drunkbatya/DrunkDashboard/hardware/production/DrunkDashboard_v2/schematic.pdf

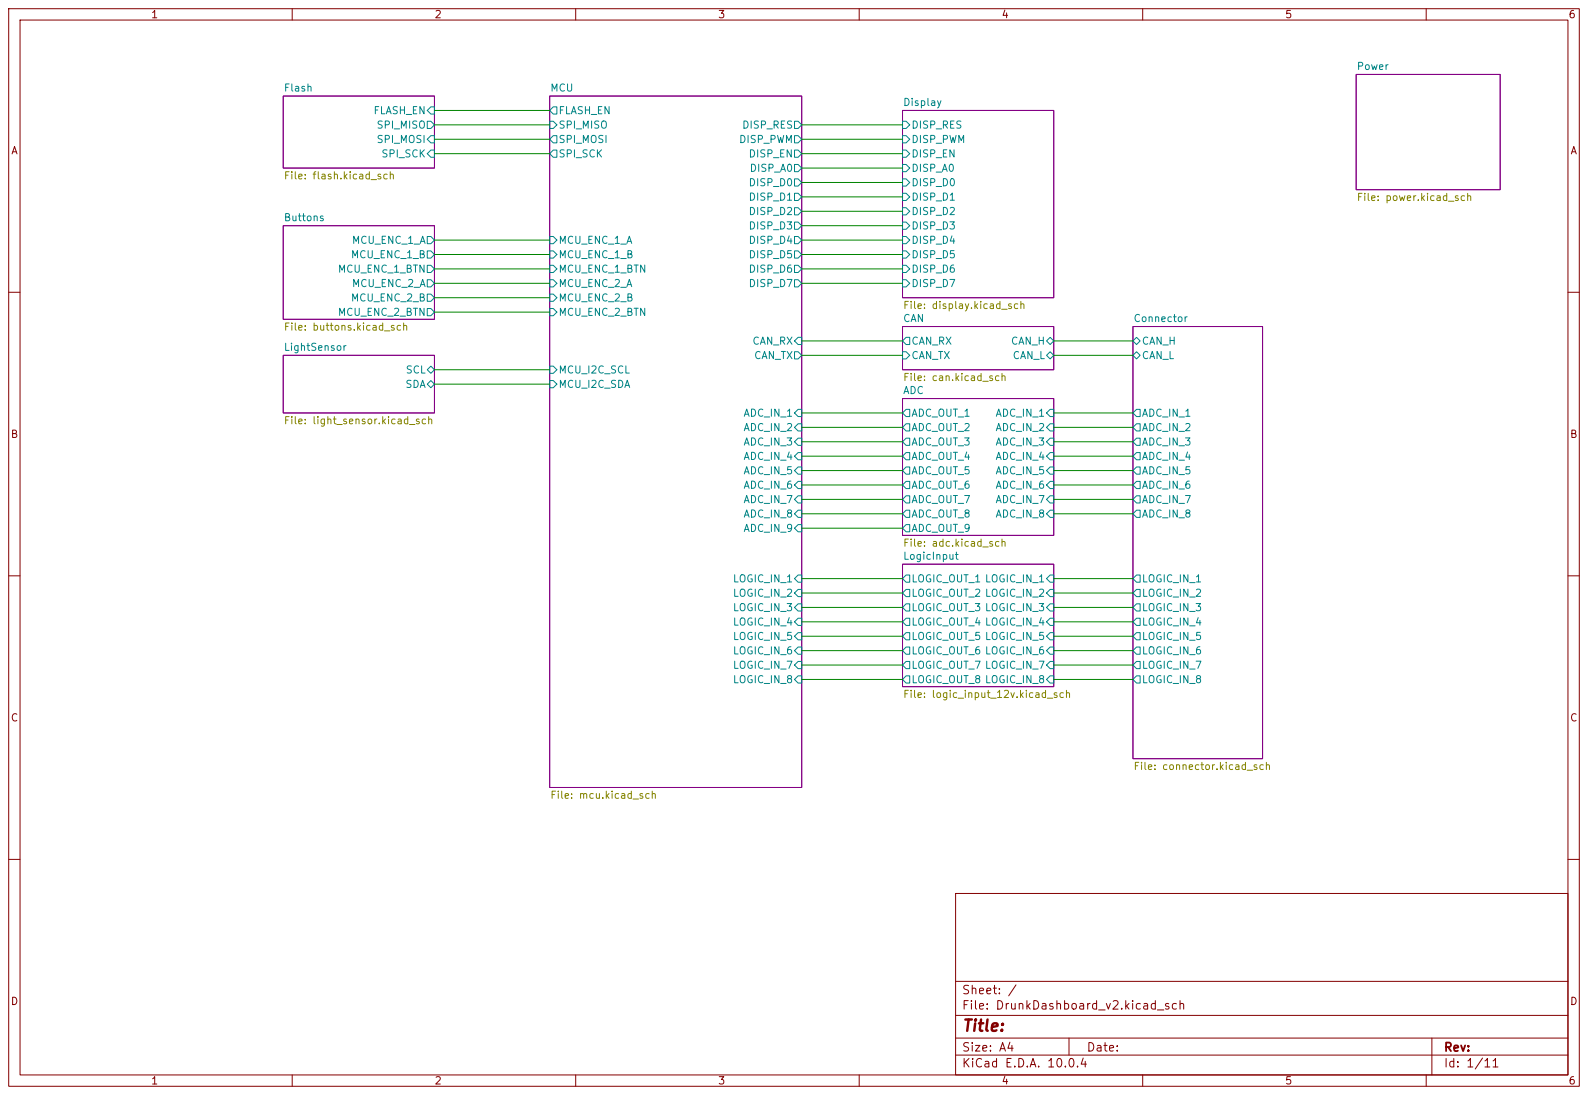
[picture p3: page 1]

LogicInput File: logic_input_12v.kicad_sch SCL SDA

Size: A4 | Rev:
KiCad E.D.A. 10.0.4 | Id: 1/11

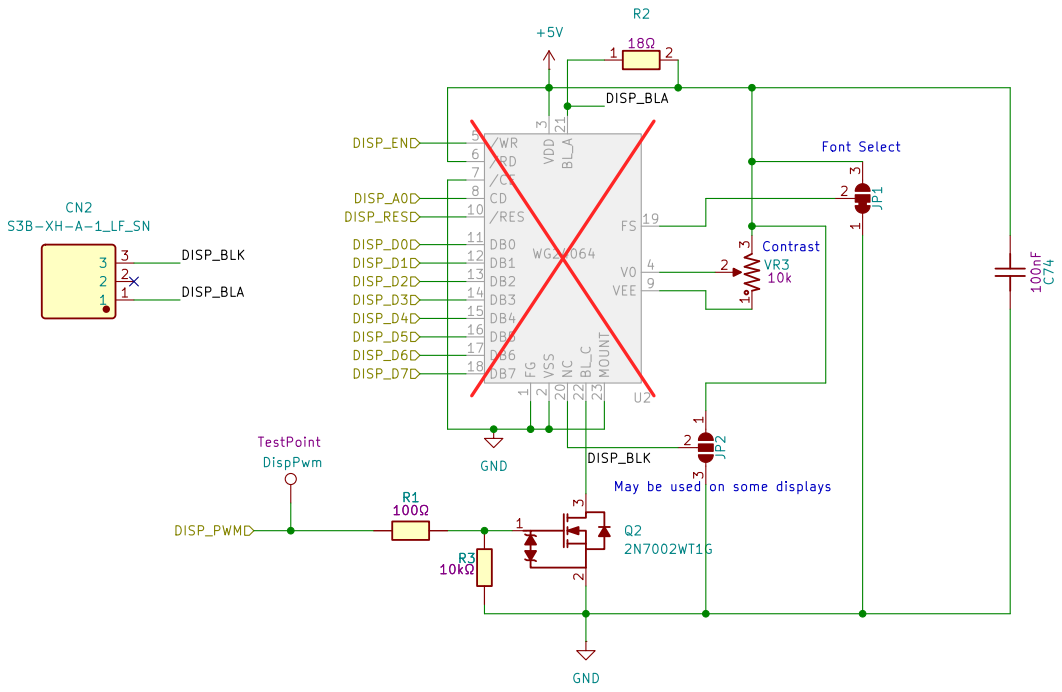
[picture p4: page 2]

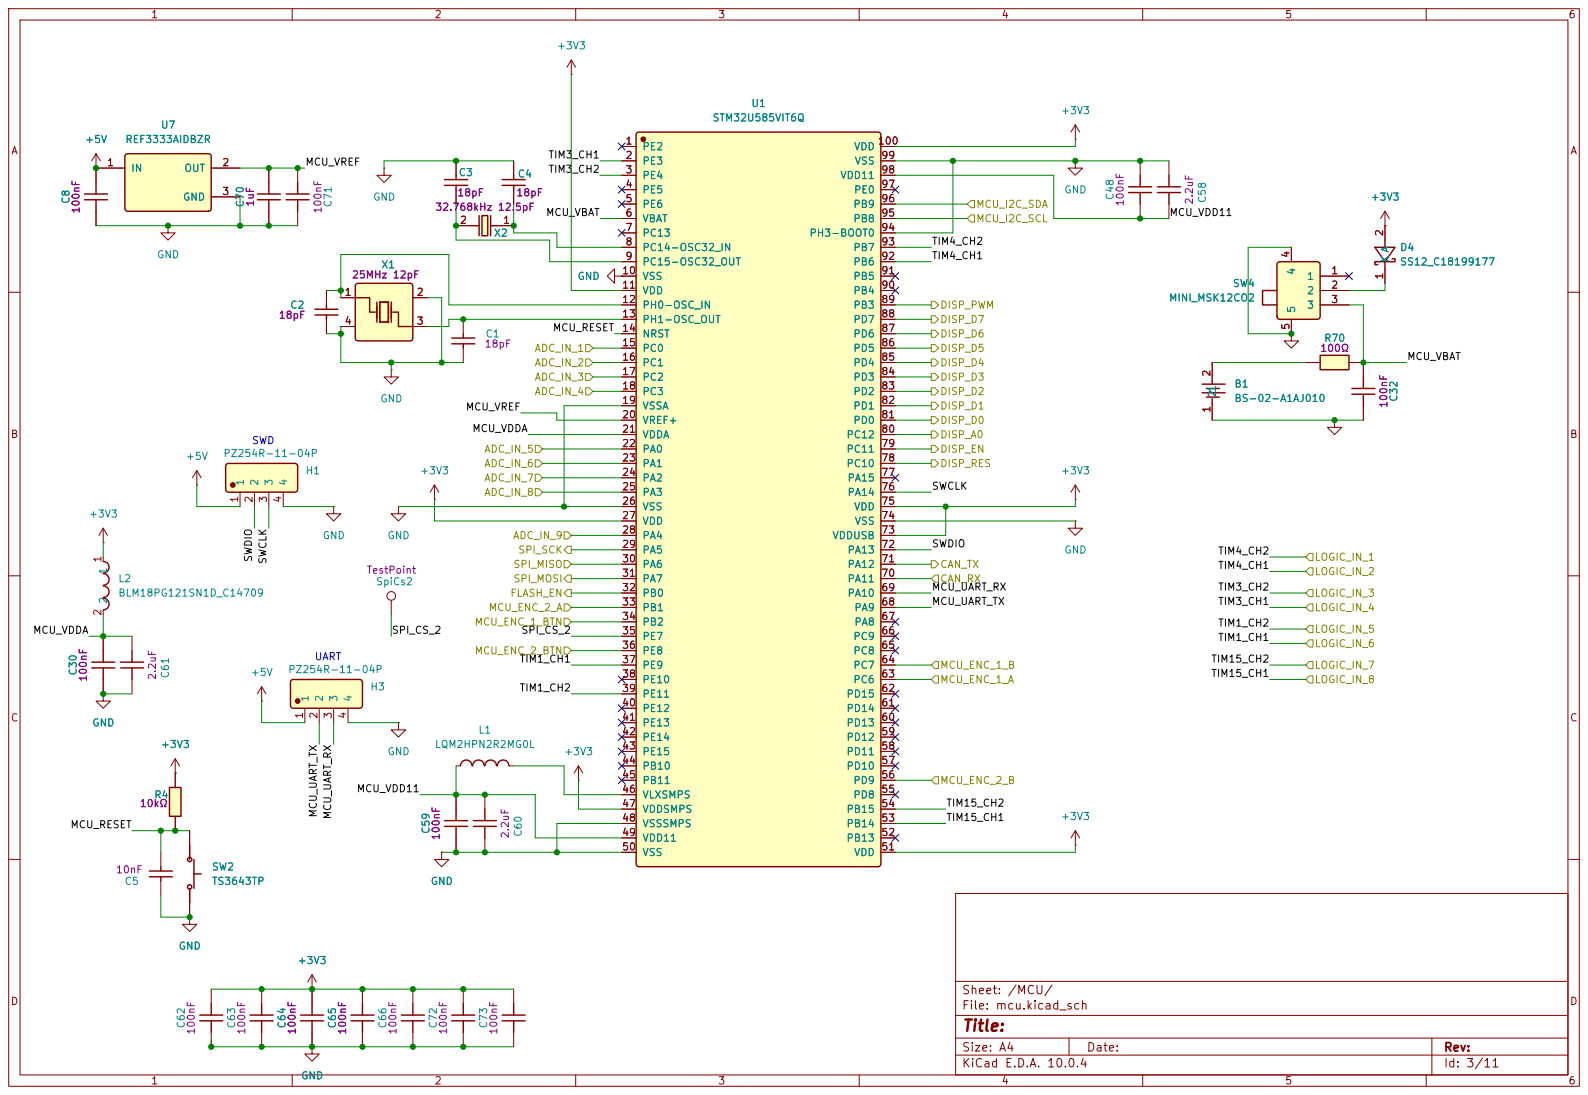
[picture p5: page 3]

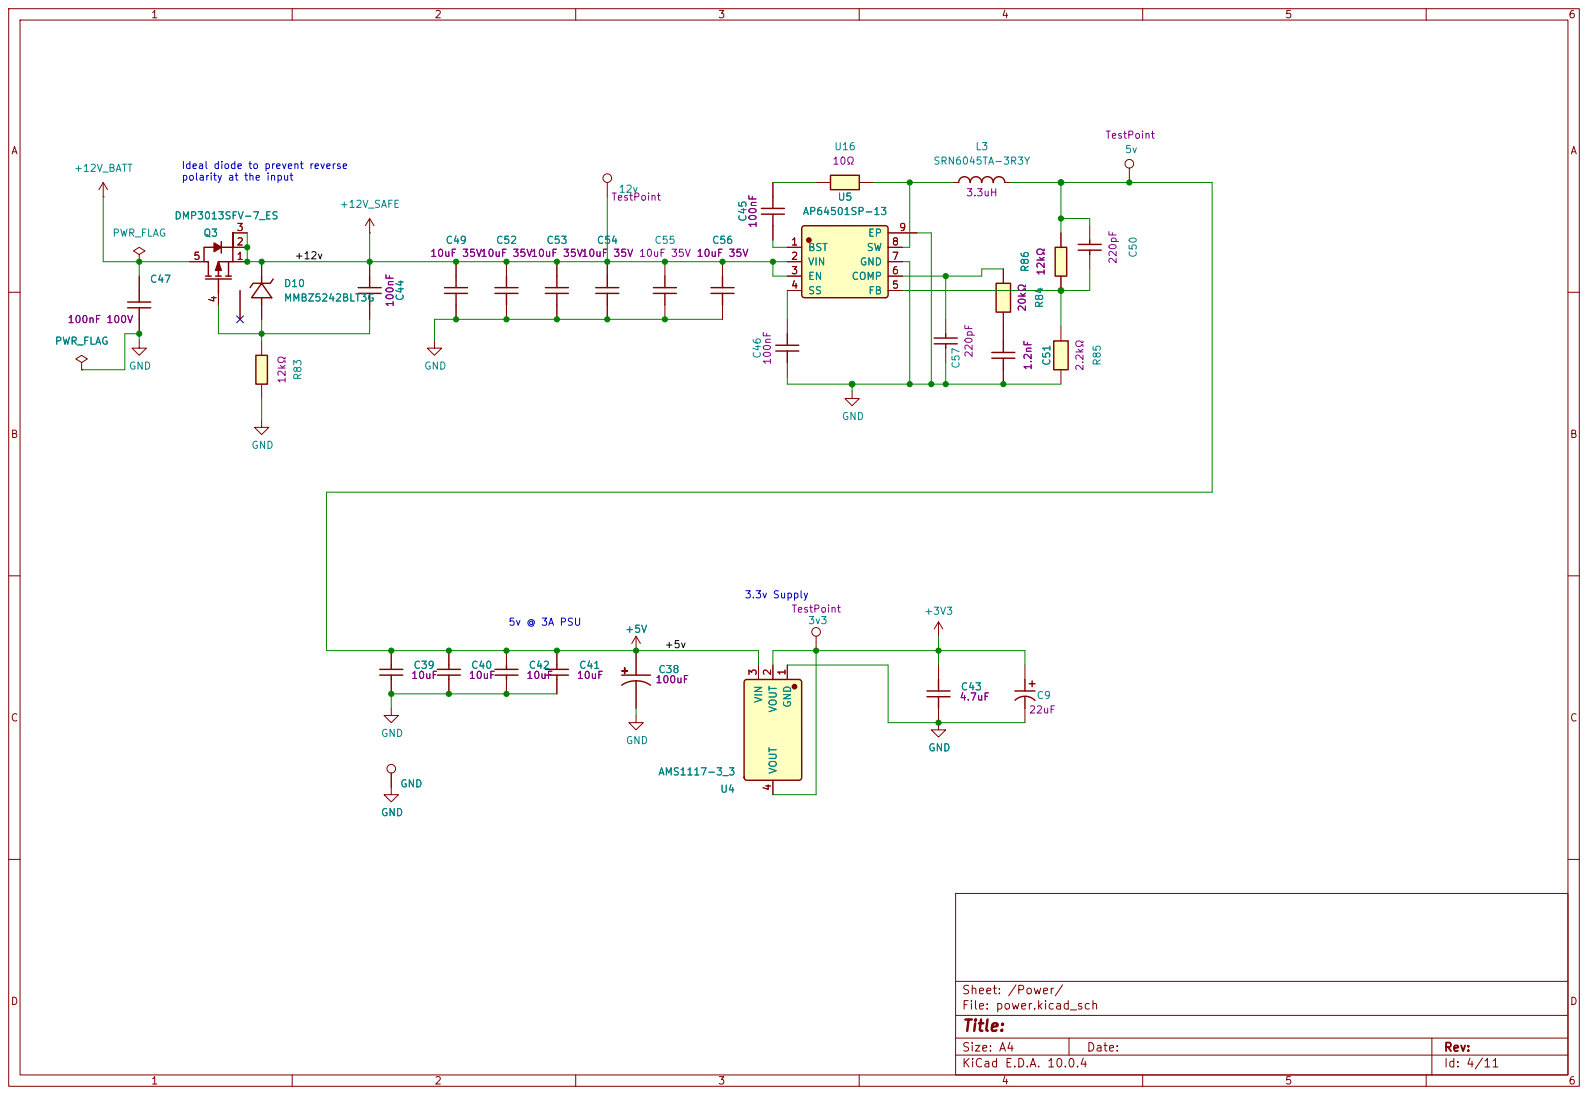
[picture p6: page 4]

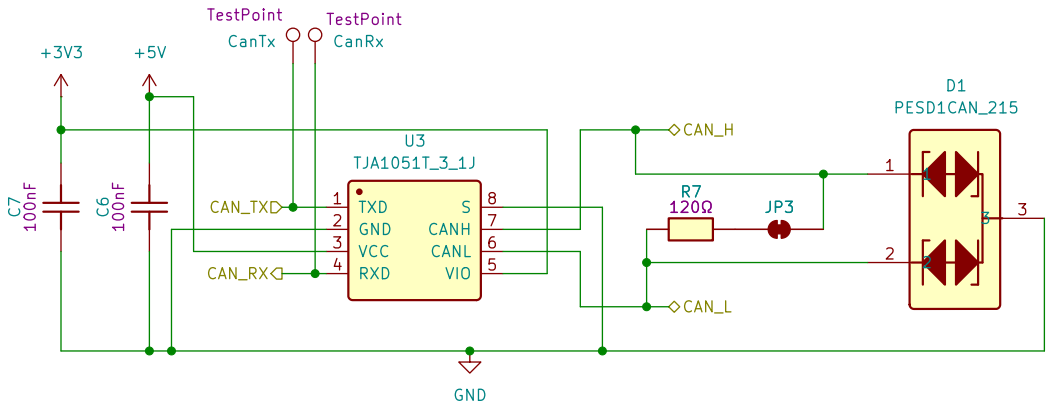
[picture p7: page 5]

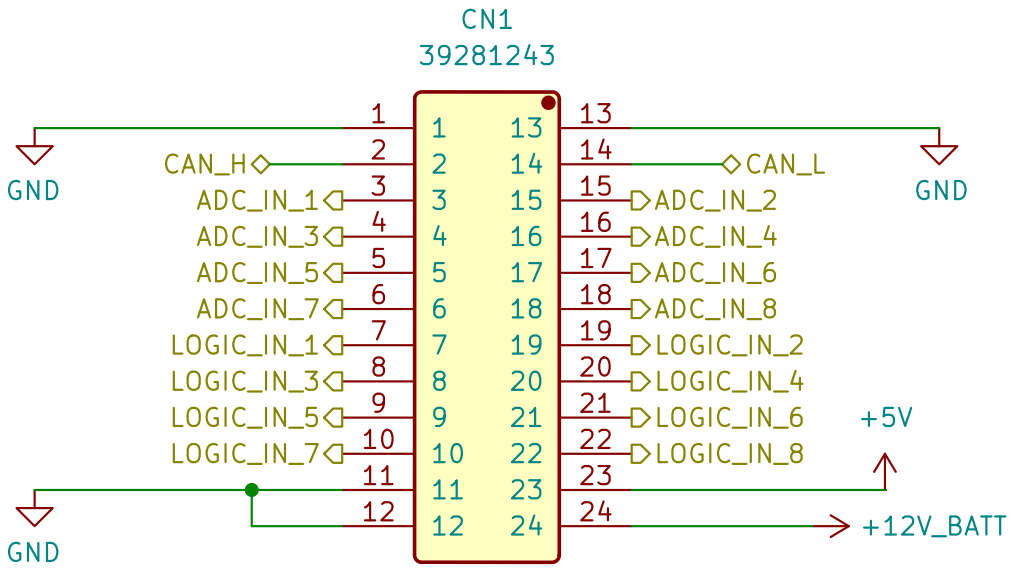
[picture p8: page 6]

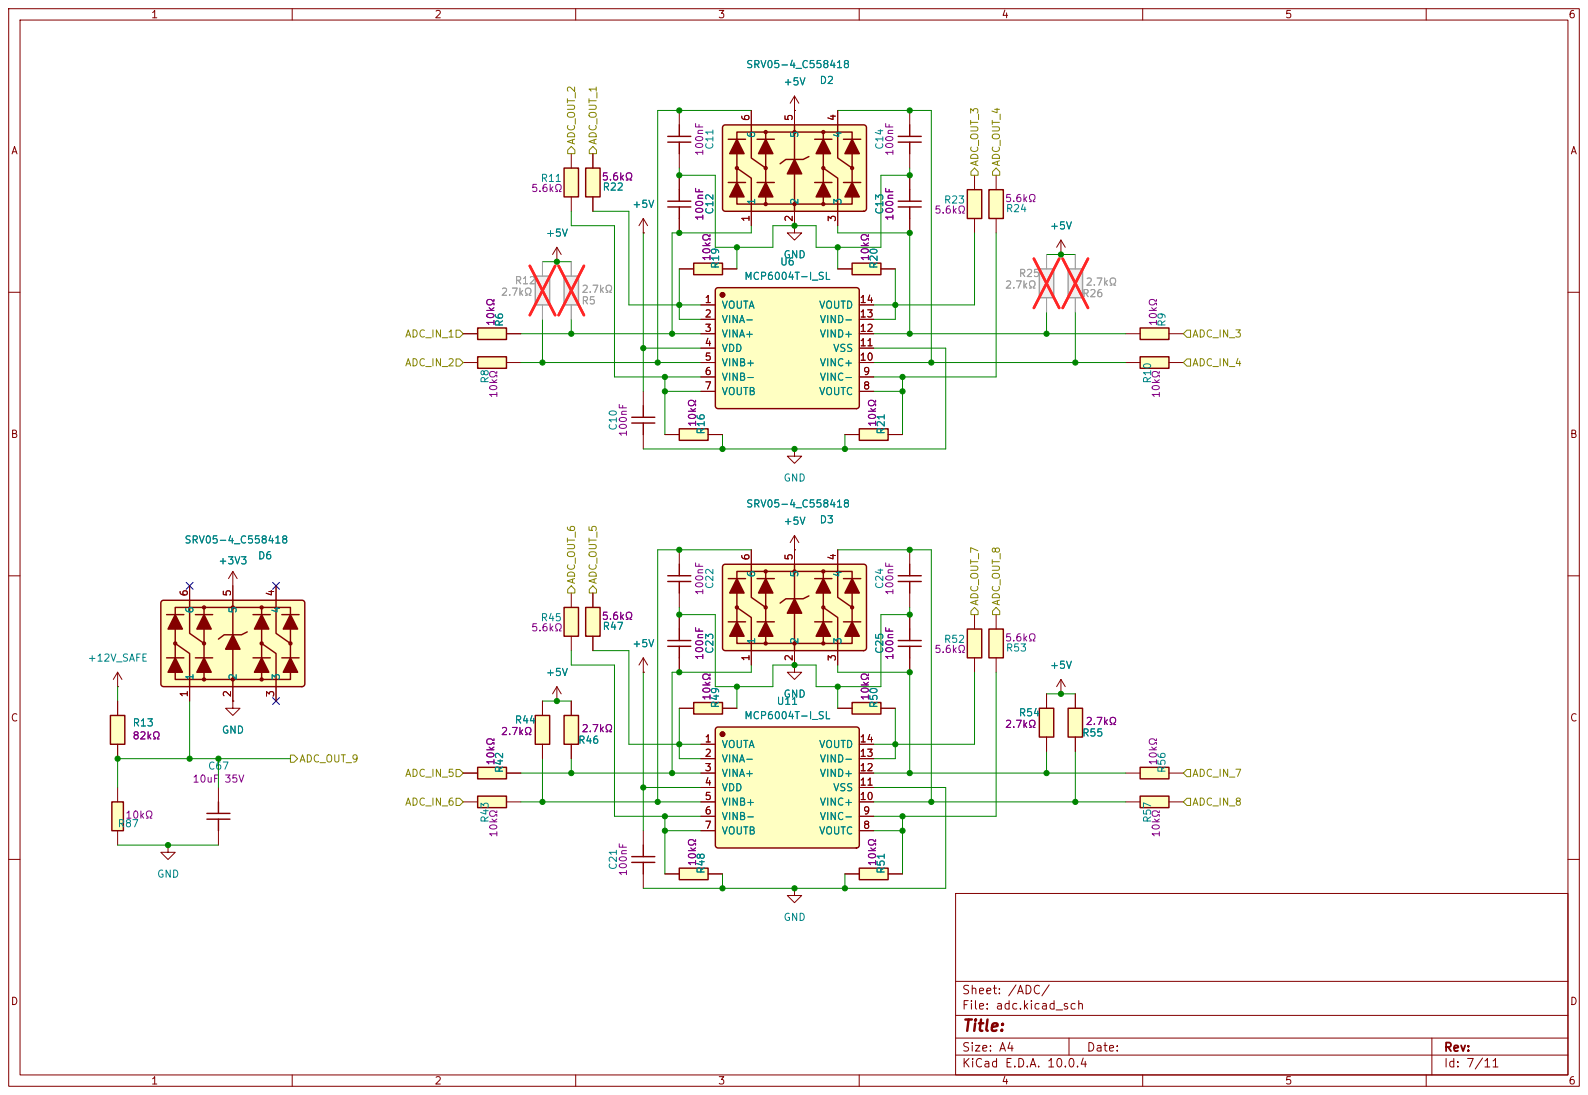
[picture p9: page 7]

VINC+ 10 VSS 11 VIND+ 12 VIND- 13 VOUTD 14 GND

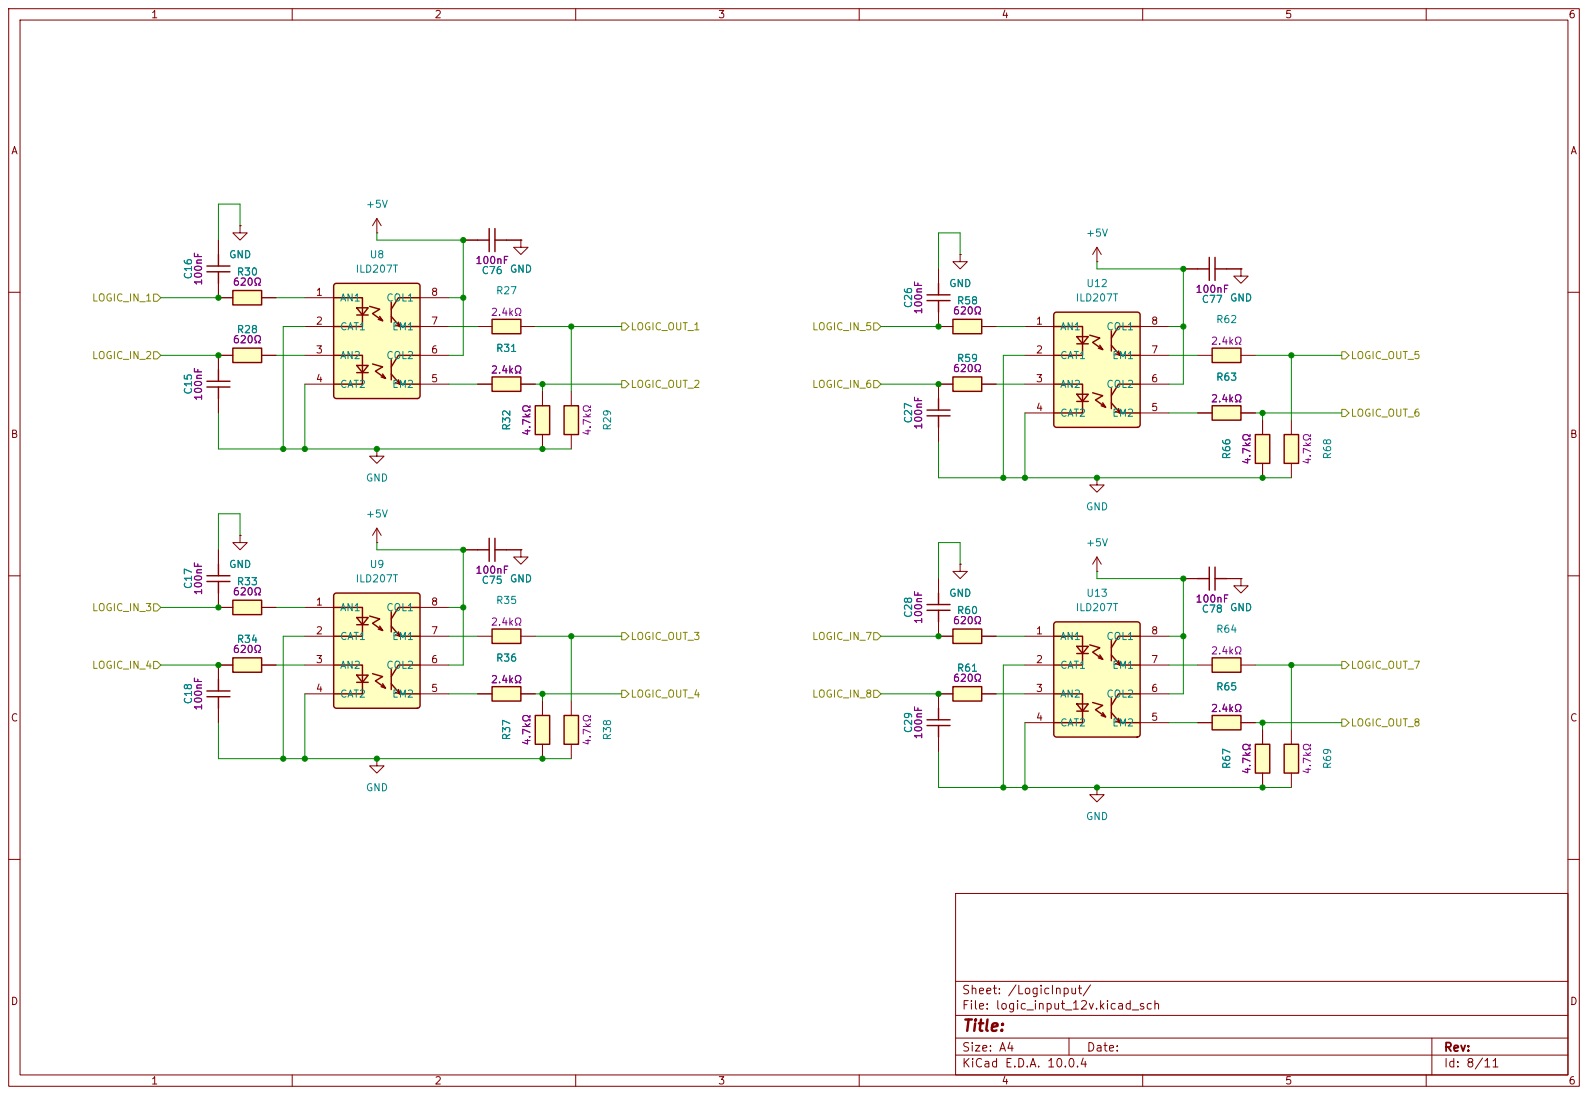
[picture p10: page 8]

AN2 3 CAT2 4

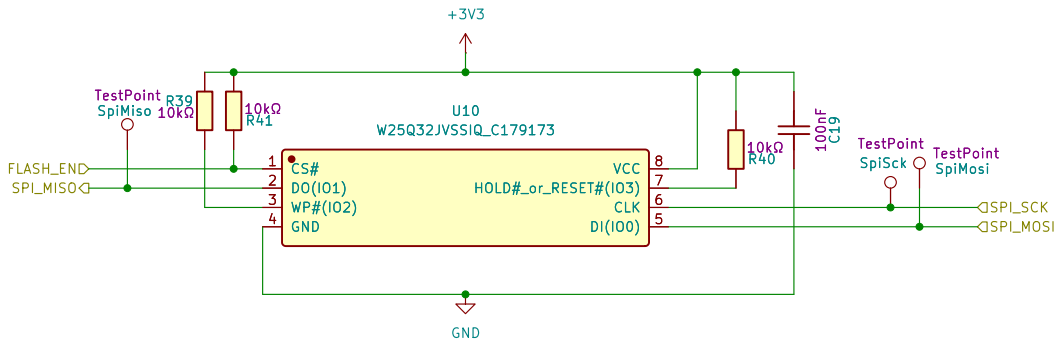
[picture p11: page 9]

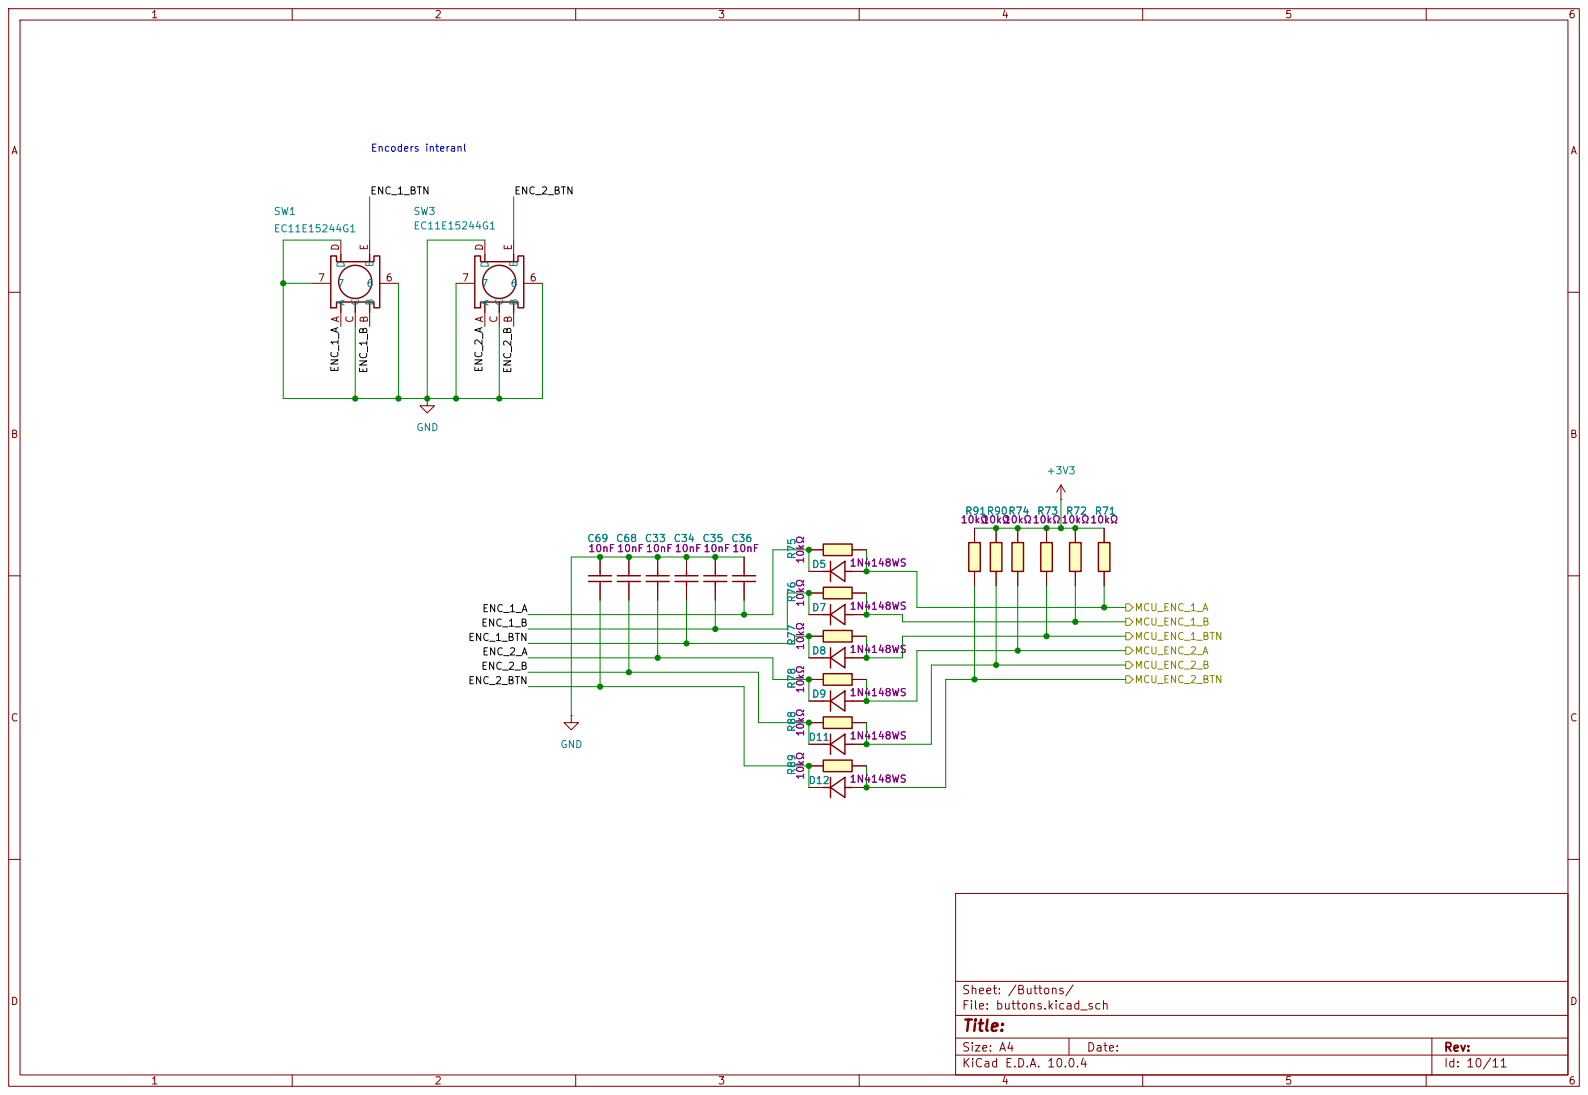
[picture p12: page 10]

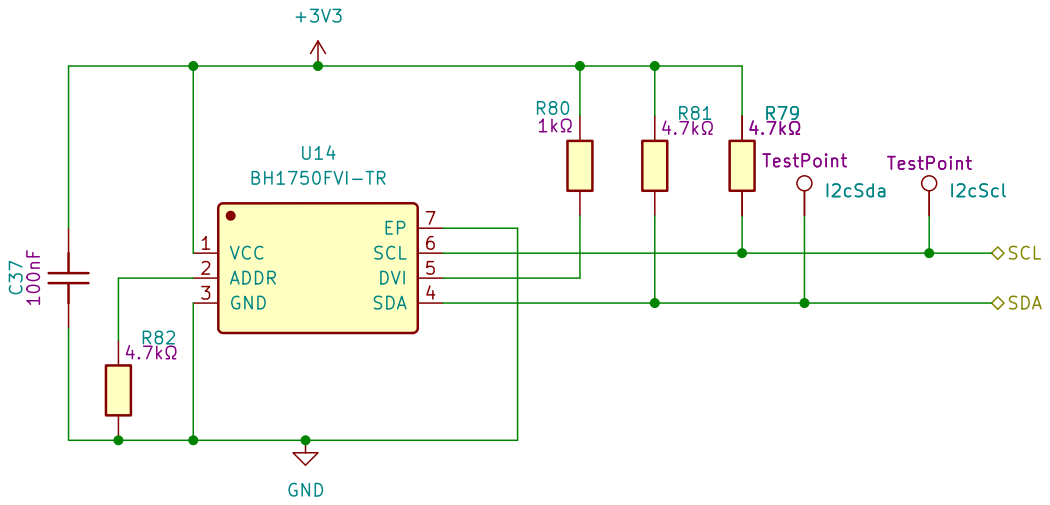
[picture p13: page 11]
