drunkbatya/DrunkDashboard/hardware/kicad/DrunkDashboard_v2/DrunkDashboard_v2.kicad_pcb

## KiCad design hardware/kicad/DrunkDashboard_v2/DrunkDashboard_v2.kicad_pcb (2026-07-02)

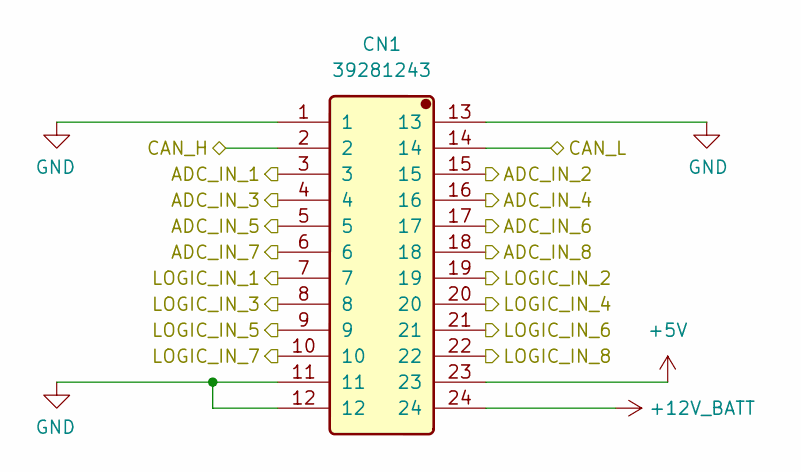
[picture p14: schematic connector.kicad_sch]

Parts:
CN1: 39281243; Manufacturer Part 39281243; LCSC C114088

Connections:
+5V: CN1.23; also elsewhere on the board
+12V_BATT: CN1.24; also elsewhere on the board
/ADC/ADC_IN_1: CN1.3; also elsewhere on the board
/ADC/ADC_IN_2: CN1.15; also elsewhere on the board
/ADC/ADC_IN_3: CN1.4; also elsewhere on the board
/ADC/ADC_IN_4: CN1.16; also elsewhere on the board
/ADC/ADC_IN_5: CN1.5; also elsewhere on the board
/ADC/ADC_IN_6: CN1.17; also elsewhere on the board
/ADC/ADC_IN_7: CN1.6; also elsewhere on the board
/ADC/ADC_IN_8: CN1.18; also elsewhere on the board
/CAN/CAN_H: CN1.2; also elsewhere on the board
/CAN/CAN_L: CN1.14; also elsewhere on the board
/Connector/LOGIC_IN_1: CN1.7; also elsewhere on the board
/Connector/LOGIC_IN_2: CN1.19; also elsewhere on the board
/Connector/LOGIC_IN_3: CN1.8; also elsewhere on the board
/Connector/LOGIC_IN_4: CN1.20; also elsewhere on the board
/Connector/LOGIC_IN_5: CN1.9; also elsewhere on the board
/Connector/LOGIC_IN_6: CN1.21; also elsewhere on the board
/Connector/LOGIC_IN_7: CN1.10; also elsewhere on the board
/Connector/LOGIC_IN_8: CN1.22; also elsewhere on the board
GND: CN1.1, CN1.11, CN1.12, CN1.13; also elsewhere on the board

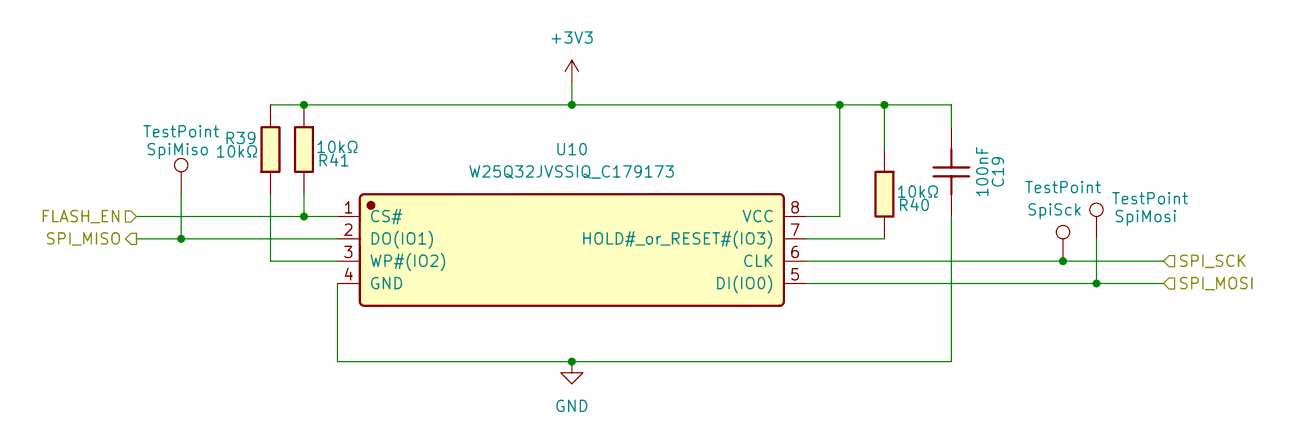
[picture p15: schematic flash.kicad_sch]

Parts:
C19: CL10B104KB8NNNC; C_0603_1608Metric; Manufacturer Part CL10B104KB8NNNC; LCSC C1591
R39, R40, R41: RT0603BRD0710KL; R_0603_1608Metric; Manufacturer Part RT0603BRD0710KL; LCSC C95204
SpiMiso_1: SpiMiso; TestPoint_Pad_D1.5mm
SpiMosi_1: SpiMosi; TestPoint_Pad_D1.5mm
SpiSck_1: SpiSck; TestPoint_Pad_D1.5mm
U10: W25Q32JVSSIQ_C179173; Manufacturer Part W25Q32JVSSIQ; LCSC C179173

Connections:
+3V3: C19.1, R39.2, R40.1, R41.1, U10.8 (VCC); also elsewhere on the board
/Flash/FLASH_EN: R41.2, U10.1 (CS#); also elsewhere on the board
/Flash/SPI_MISO: SpiMiso_1.1 (1_1), U10.2 (DO(IO1)); also elsewhere on the board
/Flash/SPI_MOSI: SpiMosi_1.1 (1_1), U10.5 (DI(IO0)); also elsewhere on the board
/Flash/SPI_SCK: SpiSck_1.1 (1_1), U10.6 (CLK); also elsewhere on the board
GND: C19.2, U10.4 (GND); also elsewhere on the board
unnamed: R40.2, U10.7 (HOLD#_or_RESET#(IO3))
unnamed: R39.1, U10.3 (WP#(IO2))

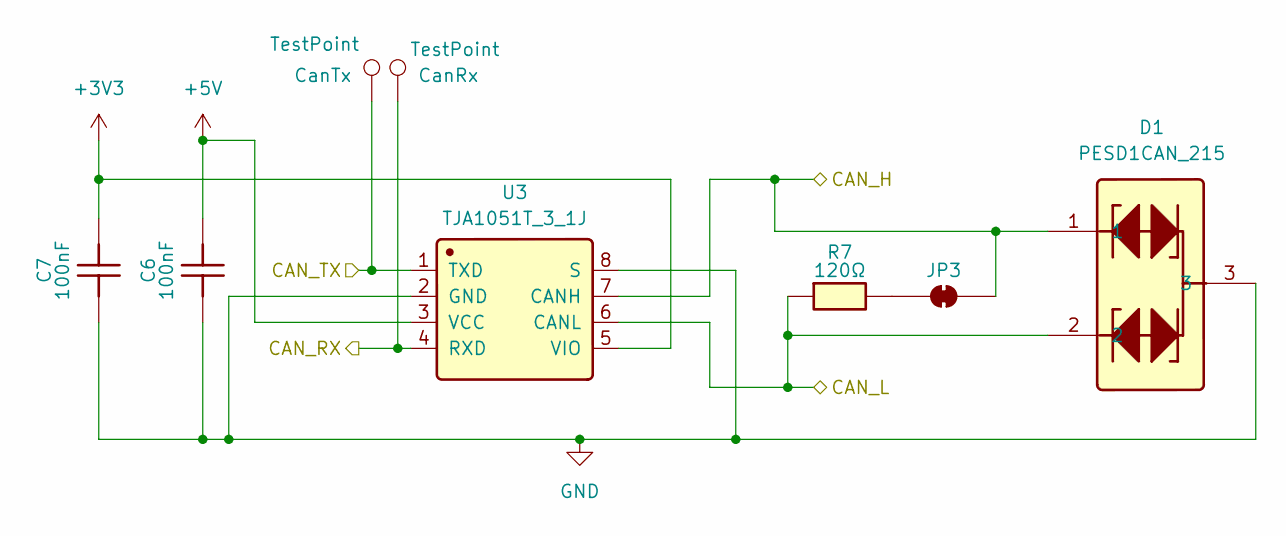
[picture p16: schematic can.kicad_sch]

Parts:
C6, C7: CL10B104KB8NNNC; C_0603_1608Metric; Manufacturer Part CL10B104KB8NNNC; LCSC C1591
CanRx_1: CanRx; TestPoint_Pad_D1.5mm
CanTx_1: CanTx; TestPoint_Pad_D1.5mm
D1: PESD1CAN_215; Manufacturer Part PESD1CAN,215; LCSC C15771
JP3: SolderJumper_2_Bridged; SolderJumper-2_P1.3mm_Bridged_RoundedPad1.0x1.5mm
R7: FRC0603F1200TS; R_0603_1608Metric; Manufacturer Part FRC0603F1200TS; LCSC C2906988
U3: TJA1051T_3_1J; Manufacturer Part TJA1051T/3/1J; LCSC C38695

Connections:
+3V3: C7.2, U3.5 (VIO); also elsewhere on the board
+5V: C6.2, U3.3 (VCC); also elsewhere on the board
/CAN/CAN_H: D1.1, JP3.2 (B), U3.7 (CANH); also elsewhere on the board
/CAN/CAN_L: D1.2, R7.1, U3.6 (CANL); also elsewhere on the board
/CAN/CAN_RX: CanRx_1.1 (1_1), U3.4 (RXD); also elsewhere on the board
/CAN/CAN_TX: CanTx_1.1 (1_1), U3.1 (TXD); also elsewhere on the board
GND: C6.1, C7.1, D1.3, U3.2 (GND), U3.8 (S); also elsewhere on the board
unnamed: JP3.1 (A), R7.2

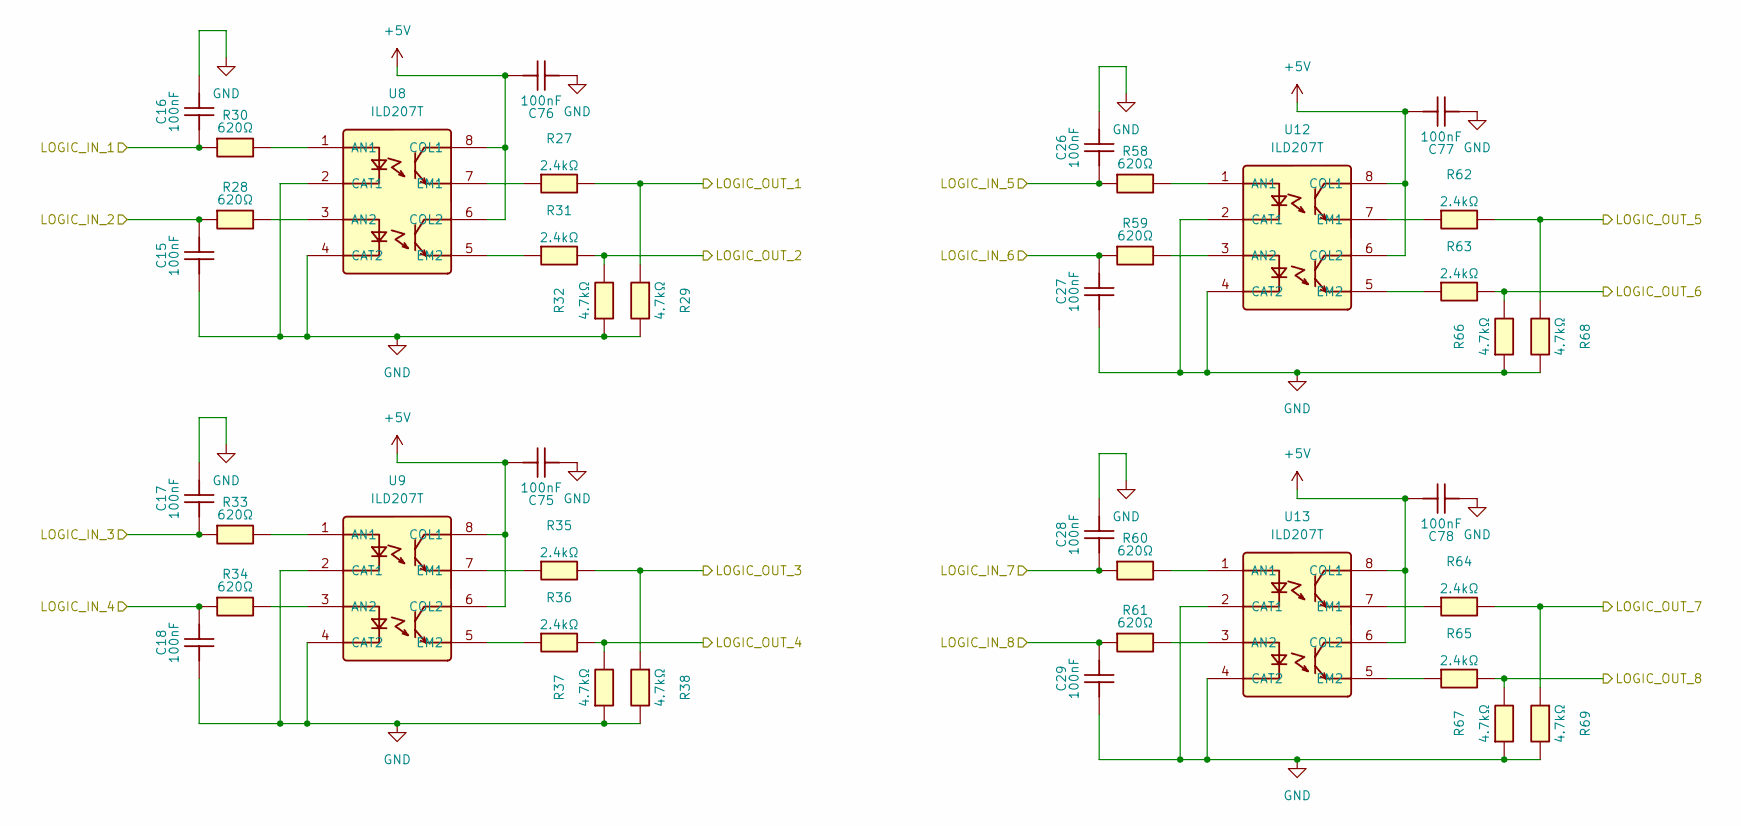
[picture p17: schematic logic_input_12v.kicad_sch]

Parts:
C15, C16, C17, C18, C26, C27, C28, C29, C75, C76, C77, C78: CL10B104KB8NNNC; C_0603_1608Metric; Manufacturer Part CL10B104KB8NNNC; LCSC C1591
R27, R31, R35, R36, R62, R63, R64, R65: FRC0603F2401TS; R_0603_1608Metric; Manufacturer Part FRC0603F2401TS; LCSC C2907007
R28, R30, R33, R34, R58, R59, R60, R61: FRC0603F6200TS; R_0603_1608Metric; Manufacturer Part FRC0603F6200TS; LCSC C2907058
R29, R32, R37, R38, R66, R67, R68, R69: FRC0603F4701TS; R_0603_1608Metric; Manufacturer Part FRC0603F4701TS; LCSC C2907034
U8, U9, U12, U13: ILD207T; Manufacturer Part ILD207T; LCSC C71049

Connections:
+5V: C75.2, C76.2, C77.2, C78.2, U8.6 (COL2), U8.8 (COL1), U9.6 (COL2), U9.8 (COL1), U12.6 (COL2), U12.8 (COL1), U13.6 (COL2), U13.8 (COL1); also elsewhere on the board
/Connector/LOGIC_IN_1: C16.1, R30.1; also elsewhere on the board
/Connector/LOGIC_IN_2: C15.2, R28.1; also elsewhere on the board
/Connector/LOGIC_IN_3: C17.1, R33.1; also elsewhere on the board
/Connector/LOGIC_IN_4: C18.2, R34.1; also elsewhere on the board
/Connector/LOGIC_IN_5: C26.1, R58.1; also elsewhere on the board
/Connector/LOGIC_IN_6: C27.2, R59.1; also elsewhere on the board
/Connector/LOGIC_IN_7: C28.1, R60.1; also elsewhere on the board
/Connector/LOGIC_IN_8: C29.2, R61.1; also elsewhere on the board
/MCU/TIM1_CH1: R63.2, R66.2; also elsewhere on the board
/MCU/TIM1_CH2: R62.2, R68.1; also elsewhere on the board
/MCU/TIM3_CH1: R36.2, R37.2; also elsewhere on the board
/MCU/TIM3_CH2: R35.2, R38.1; also elsewhere on the board
/MCU/TIM4_CH1: R31.2, R32.2; also elsewhere on the board
/MCU/TIM4_CH2: R27.2, R29.1; also elsewhere on the board
/MCU/TIM15_CH1: R65.2, R67.2; also elsewhere on the board
/MCU/TIM15_CH2: R64.2, R69.1; also elsewhere on the board
GND: C15.1, C16.2, C17.2, C18.1, C26.2, C27.1, C28.2, C29.1, C75.1, C76.1, C77.1, C78.1, R29.2, R32.1, R37.1, R38.2, R66.1, R67.1, R68.2, R69.2, U8.2 (CAT1), U8.4 (CAT2), U9.2 (CAT1), U9.4 (CAT2), U12.2 (CAT1), U12.4 (CAT2), U13.2 (CAT1), U13.4 (CAT2); also elsewhere on the board
unnamed: R30.2, U8.1 (AN1)
unnamed: R28.2, U8.3 (AN2)
unnamed: R27.1, U8.7 (EM1)
unnamed: R31.1, U8.5 (EM2)
unnamed: R33.2, U9.1 (AN1)
unnamed: R34.2, U9.3 (AN2)
unnamed: R35.1, U9.7 (EM1)
unnamed: R36.1, U9.5 (EM2)
unnamed: R58.2, U12.1 (AN1)
unnamed: R59.2, U12.3 (AN2)
unnamed: R62.1, U12.7 (EM1)
unnamed: R63.1, U12.5 (EM2)
unnamed: R60.2, U13.1 (AN1)
unnamed: R61.2, U13.3 (AN2)
unnamed: R64.1, U13.7 (EM1)
unnamed: R65.1, U13.5 (EM2)

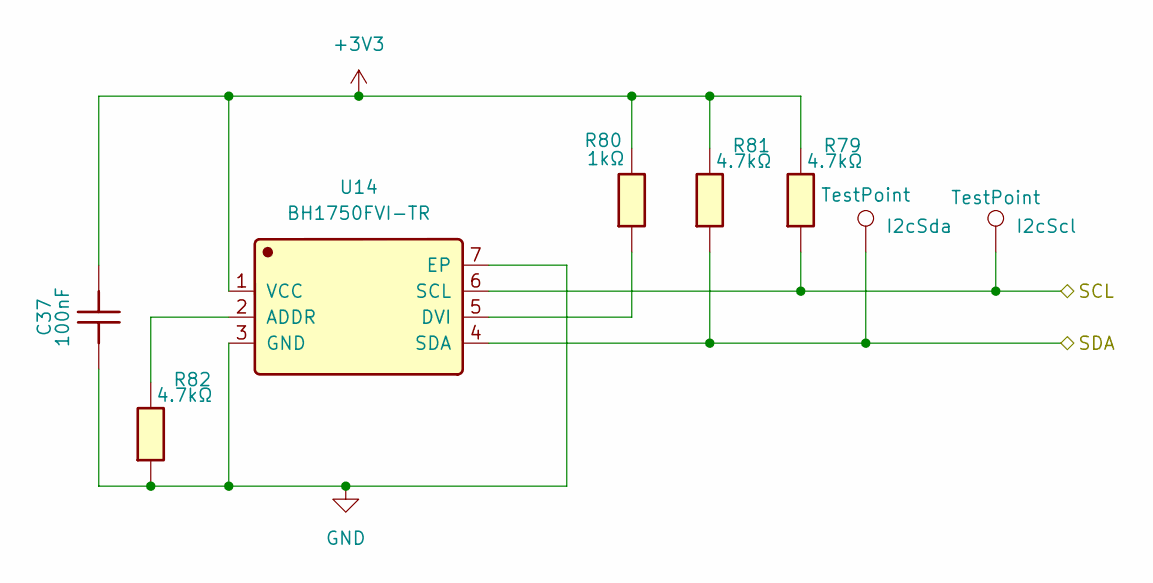
[picture p18: schematic light_sensor.kicad_sch]

Parts:
C37: CL10B104KB8NNNC; C_0603_1608Metric; Manufacturer Part CL10B104KB8NNNC; LCSC C1591
I2cScl_1: I2cScl; TestPoint_Pad_D1.5mm
I2cSda_1: I2cSda; TestPoint_Pad_D1.5mm
R79, R81, R82: FRC0603F4701TS; R_0603_1608Metric; Manufacturer Part FRC0603F4701TS; LCSC C2907034
R80: FRC0603F1001TS; R_0603_1608Metric; Manufacturer Part FRC0603F1001TS; LCSC C2907002
U14: BH1750FVI-TR; Manufacturer Part BH1750FVI-TR; LCSC C78960

Connections:
+3V3: C37.2, R79.2, R80.2, R81.2, U14.1 (VCC); also elsewhere on the board
/LightSensor/SCL: I2cScl_1.1 (1_1), R79.1, U14.6 (SCL); also elsewhere on the board
/LightSensor/SDA: I2cSda_1.1 (1_1), R81.1, U14.4 (SDA); also elsewhere on the board
GND: C37.1, R82.1, U14.3 (GND), U14.7 (EP); also elsewhere on the board
unnamed: R82.2, U14.2 (ADDR)
unnamed: R80.1, U14.5 (DVI)

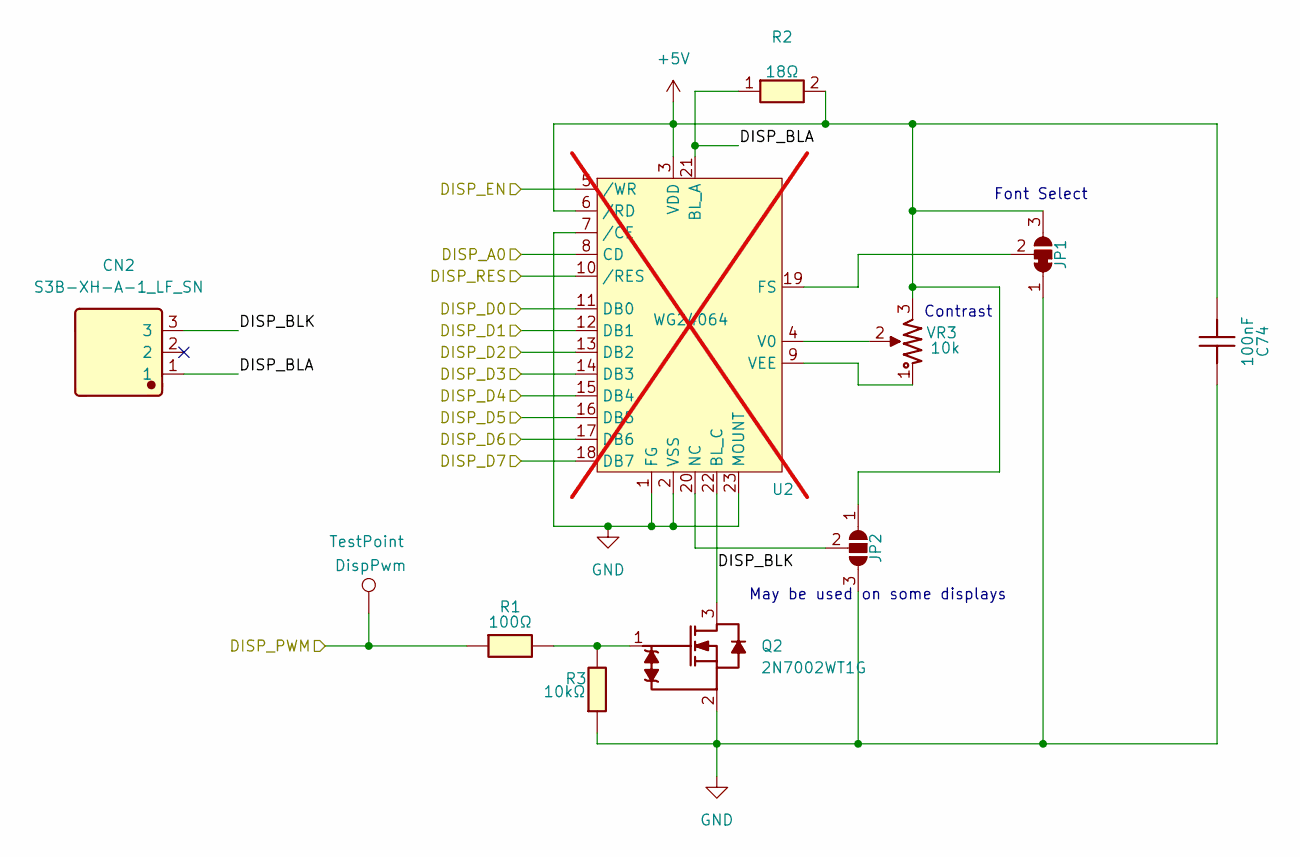
[picture p19: schematic display.kicad_sch]

Parts:
C74: CL10B104KB8NNNC; C_0603_1608Metric; Manufacturer Part CL10B104KB8NNNC; LCSC C1591
CN2: S3B-XH-A-1_LF_SN; Manufacturer Part S3B-XH-A-1(LF)(SN); LCSC C163036
DispPwm1: DispPwm; TestPoint_Pad_D1.5mm
JP1: SolderJumper_3_Bridged12; SolderJumper-3_P1.3mm_Bridged2Bar12_RoundedPad1.0x1.5mm
JP2: SolderJumper_3_Open; SolderJumper-3_P1.3mm_Open_RoundedPad1.0x1.5mm
Q2: 2N7002WT1G; SOT-323_SC-70; Manufacturer Part 2N7002WT1G; LCSC C232391
R1: PTFR0603B100RN9; R_0603_1608Metric; Manufacturer Part PTFR0603B100RN9; LCSC C394538
R2: RK73B2ETTD180J; R_1210_3225Metric; Manufacturer Part RK73B2ETTD180J; LCSC C830159
R3: RT0603BRD0710KL; R_0603_1608Metric; Manufacturer Part RT0603BRD0710KL; LCSC C95204
U2: WG24064; not fitted
VR3: 3362P-1-103LF_C48997950; Manufacturer Part 3362P-1-103LF; LCSC C48997950

Connections:
+5V: C74.2, JP1.3 (B), JP2.1 (A), R2.2, U2.3 (VDD), U2.6 (/RD), VR3.3; also elsewhere on the board
/Display/DISP_A0: U2.8 (CD); also elsewhere on the board
/Display/DISP_BLA: CN2.1, R2.1, U2.21 (BL_A)
/Display/DISP_BLK: CN2.3, Q2.3 (D), U2.22 (BL_C)
/Display/DISP_D0: U2.11 (DB0); also elsewhere on the board
/Display/DISP_D1: U2.12 (DB1); also elsewhere on the board
/Display/DISP_D2: U2.13 (DB2); also elsewhere on the board
/Display/DISP_D3: U2.14 (DB3); also elsewhere on the board
/Display/DISP_D4: U2.15 (DB4); also elsewhere on the board
/Display/DISP_D5: U2.16 (DB5); also elsewhere on the board
/Display/DISP_D6: U2.17 (DB6); also elsewhere on the board
/Display/DISP_D7: U2.18 (DB7); also elsewhere on the board
/Display/DISP_EN: U2.5 (/WR); also elsewhere on the board
/Display/DISP_PWM: DispPwm1.1 (1_1), R1.1; also elsewhere on the board
/Display/DISP_RES: U2.10 (/RES); also elsewhere on the board
GND: C74.1, JP1.1 (A), JP2.3 (B), Q2.2 (S), R3.1, U2.1 (FG), U2.2 (VSS), U2.7 (/CE), U2.23 (MOUNT); also elsewhere on the board
unnamed: JP1.2 (C), U2.19 (FS)
unnamed: JP2.2 (C), U2.20 (NC)
unnamed: Q2.1 (G), R1.2, R3.2
unnamed: U2.4 (V0), VR3.2
unnamed: U2.9 (VEE), VR3.1

Notes on the sheet:
May be used on some displays
Font Select
Contrast

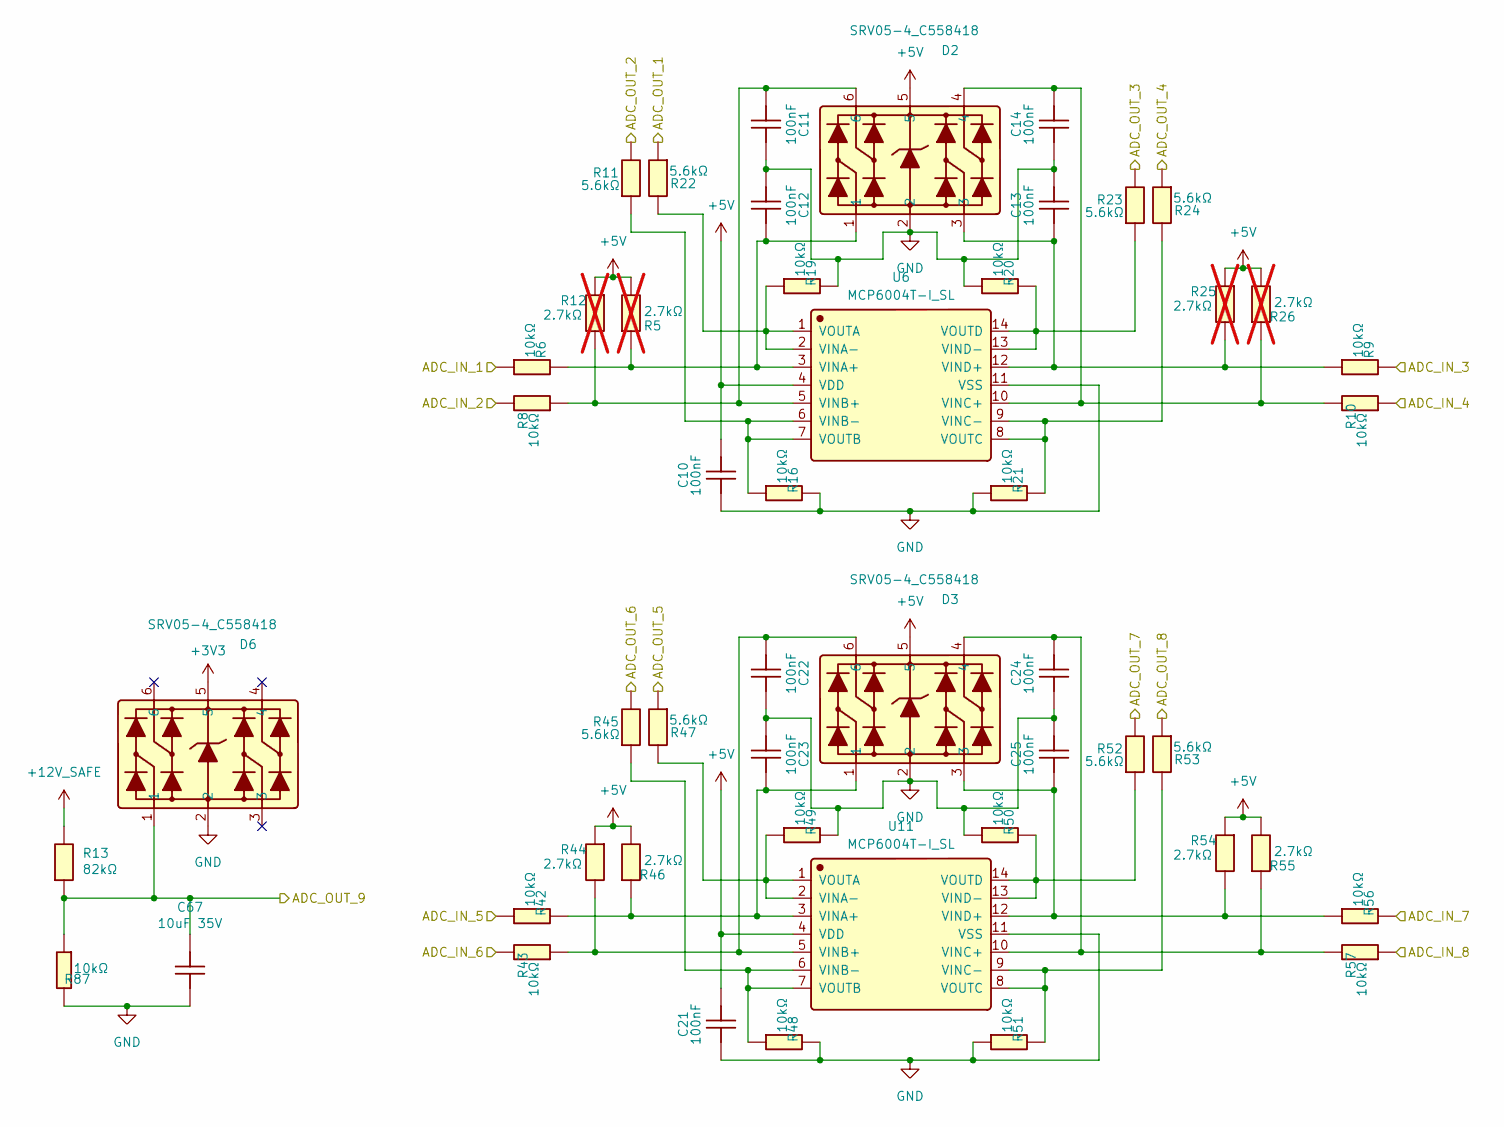
[picture p20: schematic adc.kicad_sch]

Parts:
C10, C11, C12, C13, C14, C21, C22, C23, C24, C25: CL10B104KB8NNNC; C_0603_1608Metric; Manufacturer Part CL10B104KB8NNNC; LCSC C1591
C67: GRM21BC8YA106KE11L; C_0805_2012Metric; Manufacturer Part GRM21BC8YA106KE11L; LCSC C469541
D2, D3, D6: SRV05-4_C558418; Manufacturer Part SRV05-4; LCSC C558418
R5, R12, R25, R26: FRC0603F2701TS; R_0603_1608Metric; Manufacturer Part FRC0603F2701TS; LCSC C2907008; not fitted
R6, R8, R9, R10, R16, R19, R20, R21, R42, R43, R48, R49, R50, R51, R56, R57, R87: RT0603BRD0710KL; R_0603_1608Metric; Manufacturer Part RT0603BRD0710KL; LCSC C95204
R11, R22, R23, R24, R45, R47, R52, R53: FRC0603F5601TS; R_0603_1608Metric; Manufacturer Part FRC0603F5601TS; LCSC C2907046
R13: FRC0603F8202TS; R_0603_1608Metric; Manufacturer Part FRC0603F8202TS; LCSC C2907072
R44, R46, R54, R55: FRC0603F2701TS; R_0603_1608Metric; Manufacturer Part FRC0603F2701TS; LCSC C2907008
U6, U11: MCP6004T-I_SL; Manufacturer Part MCP6004T-I/SL; LCSC C7378

Connections:
+3V3: D6.5; also elsewhere on the board
+5V: C10.2, C21.2, D2.5, D3.5, R5.2, R12.1, R25.1, R26.2, R44.1, R46.2, R54.1, R55.2, U6.4 (VDD), U11.4 (VDD); also elsewhere on the board
+12V_SAFE: R13.2; also elsewhere on the board
/ADC/ADC_IN_1: R6.1; also elsewhere on the board
/ADC/ADC_IN_2: R8.2; also elsewhere on the board
/ADC/ADC_IN_3: R9.2; also elsewhere on the board
/ADC/ADC_IN_4: R10.1; also elsewhere on the board
/ADC/ADC_IN_5: R42.1; also elsewhere on the board
/ADC/ADC_IN_6: R43.2; also elsewhere on the board
/ADC/ADC_IN_7: R56.2; also elsewhere on the board
/ADC/ADC_IN_8: R57.1; also elsewhere on the board
/ADC/ADC_OUT_1: R22.1; also elsewhere on the board
/ADC/ADC_OUT_2: R11.2; also elsewhere on the board
/ADC/ADC_OUT_3: R23.2; also elsewhere on the board
/ADC/ADC_OUT_4: R24.1; also elsewhere on the board
/ADC/ADC_OUT_5: R47.1; also elsewhere on the board
/ADC/ADC_OUT_6: R45.2; also elsewhere on the board
/ADC/ADC_OUT_7: R52.2; also elsewhere on the board
/ADC/ADC_OUT_8: R53.1; also elsewhere on the board
/ADC/ADC_OUT_9: C67.2, D6.1, R13.1, R87.1; also elsewhere on the board
GND: C10.1, C11.2, C12.1, C13.2, C14.1, C21.1, C22.2, C23.1, C24.1, C25.2, C67.1, D2.2, D3.2, D6.2, R16.2, R19.2, R20.1, R21.1, R48.2, R49.2, R50.1, R51.1, R87.2, U6.11 (VSS), U11.11 (VSS); also elsewhere on the board
unnamed: C12.2, D2.1, R5.1, R6.2, U6.3 (VINA+)
unnamed: R19.1, R22.2, U6.1 (VOUTA), U6.2 (VINA-)
unnamed: C11.1, D2.6, R8.1, R12.2, U6.5 (VINB+)
unnamed: R11.1, R16.1, U6.6 (VINB-), U6.7 (VOUTB)
unnamed: C14.2, D2.4, R10.2, R26.1, U6.10 (VINC+)
unnamed: R21.2, R24.2, U6.8 (VOUTC), U6.9 (VINC-)
unnamed: C13.1, D2.3, R9.1, R25.2, U6.12 (VIND+)
unnamed: R20.2, R23.1, U6.13 (VIND-), U6.14 (VOUTD)
unnamed: C23.2, D3.1, R42.2, R46.1, U11.3 (VINA+)
unnamed: R47.2, R49.1, U11.1 (VOUTA), U11.2 (VINA-)
unnamed: C22.1, D3.6, R43.1, R44.2, U11.5 (VINB+)
unnamed: R45.1, R48.1, U11.6 (VINB-), U11.7 (VOUTB)
unnamed: C24.2, D3.4, R55.1, R57.2, U11.10 (VINC+)
unnamed: R51.2, R53.2, U11.8 (VOUTC), U11.9 (VINC-)
unnamed: C25.1, D3.3, R54.2, R56.1, U11.12 (VIND+)
unnamed: R50.2, R52.1, U11.13 (VIND-), U11.14 (VOUTD)

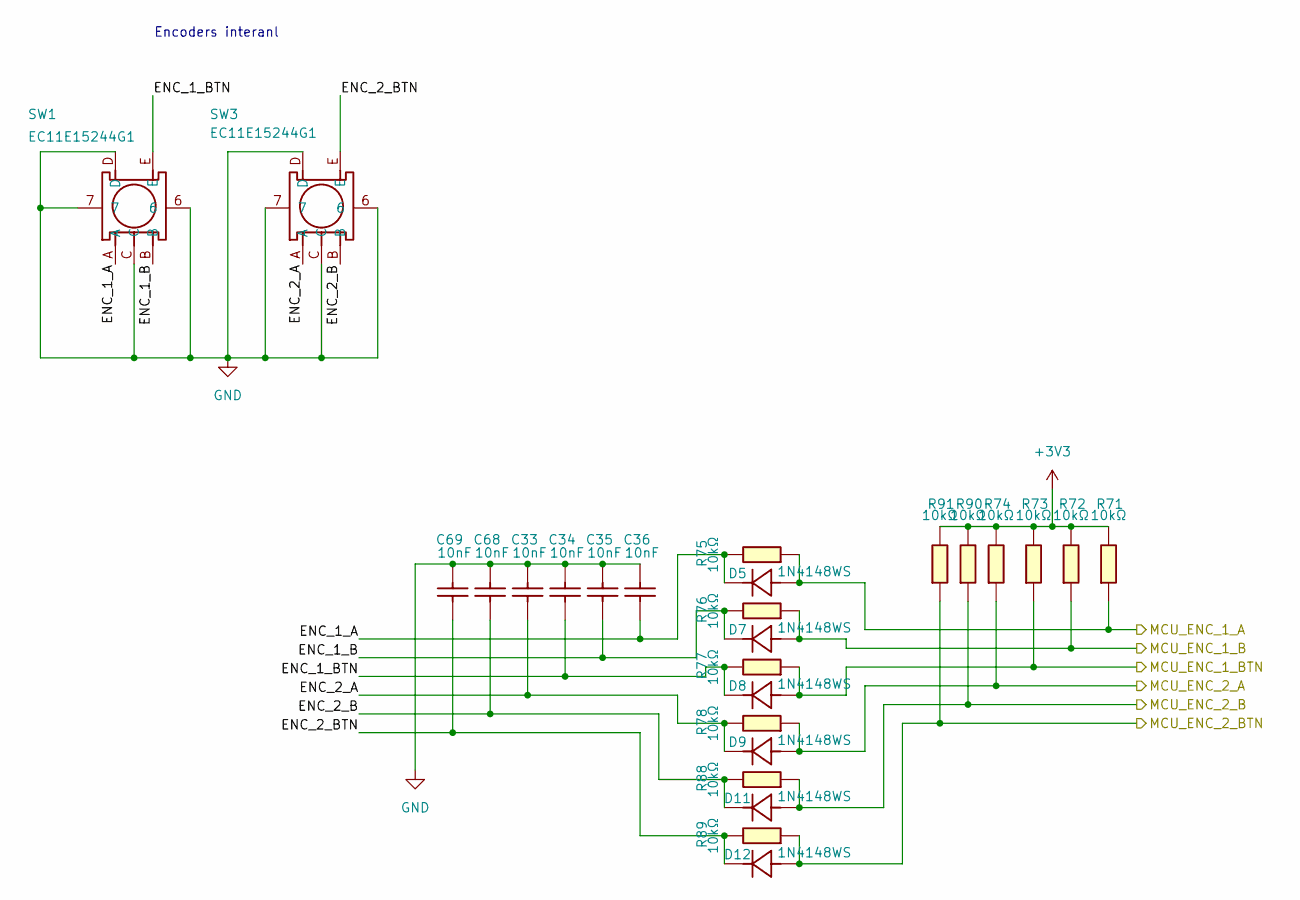
[picture p21: schematic buttons.kicad_sch]

Parts:
C33, C34, C35, C36, C68, C69: CC0603KRX7R0BB103; C_0603_1608Metric; Manufacturer Part CC0603KRX7R0BB103; LCSC C107059
D5, D7, D8, D9, D11, D12: 1N4148WS_C917117; Manufacturer Part 1N4148WS; LCSC C917117
R71, R72, R73, R74, R75, R76, R77, R78, R88, R89, R90, R91: RT0603BRD0710KL; R_0603_1608Metric; Manufacturer Part RT0603BRD0710KL; LCSC C95204
SW1, SW3: EC11E15244G1; Manufacturer Part EC11E15244G1; LCSC C370970

Connections:
+3V3: R71.2, R72.2, R73.2, R74.2, R90.2, R91.2; also elsewhere on the board
/Buttons/ENC_1_A: C36.2, D5.1 (C), R75.2, SW1.A
/Buttons/ENC_1_B: C35.2, D7.1 (C), R76.2, SW1.B
/Buttons/ENC_1_BTN: C34.2, D8.1 (C), R77.2, SW1.E
/Buttons/ENC_2_A: C33.2, D9.1 (C), R78.2, SW3.A
/Buttons/ENC_2_B: C68.2, D11.1 (C), R88.2, SW3.B
/Buttons/ENC_2_BTN: C69.2, D12.1 (C), R89.2, SW3.E
/Buttons/MCU_ENC_1_A: D5.2 (A), R71.1, R75.1; also elsewhere on the board
/Buttons/MCU_ENC_1_B: D7.2 (A), R72.1, R76.1; also elsewhere on the board
/Buttons/MCU_ENC_1_BTN: D8.2 (A), R73.1, R77.1; also elsewhere on the board
/Buttons/MCU_ENC_2_A: D9.2 (A), R74.1, R78.1; also elsewhere on the board
/Buttons/MCU_ENC_2_B: D11.2 (A), R88.1, R90.1; also elsewhere on the board
/Buttons/MCU_ENC_2_BTN: D12.2 (A), R89.1, R91.1; also elsewhere on the board
GND: C33.1, C34.1, C35.1, C36.1, C68.1, C69.1, SW1.6, SW1.7, SW1.C, SW1.D, SW3.6, SW3.7, SW3.C, SW3.D; also elsewhere on the board

Notes on the sheet:
Encoders interanl

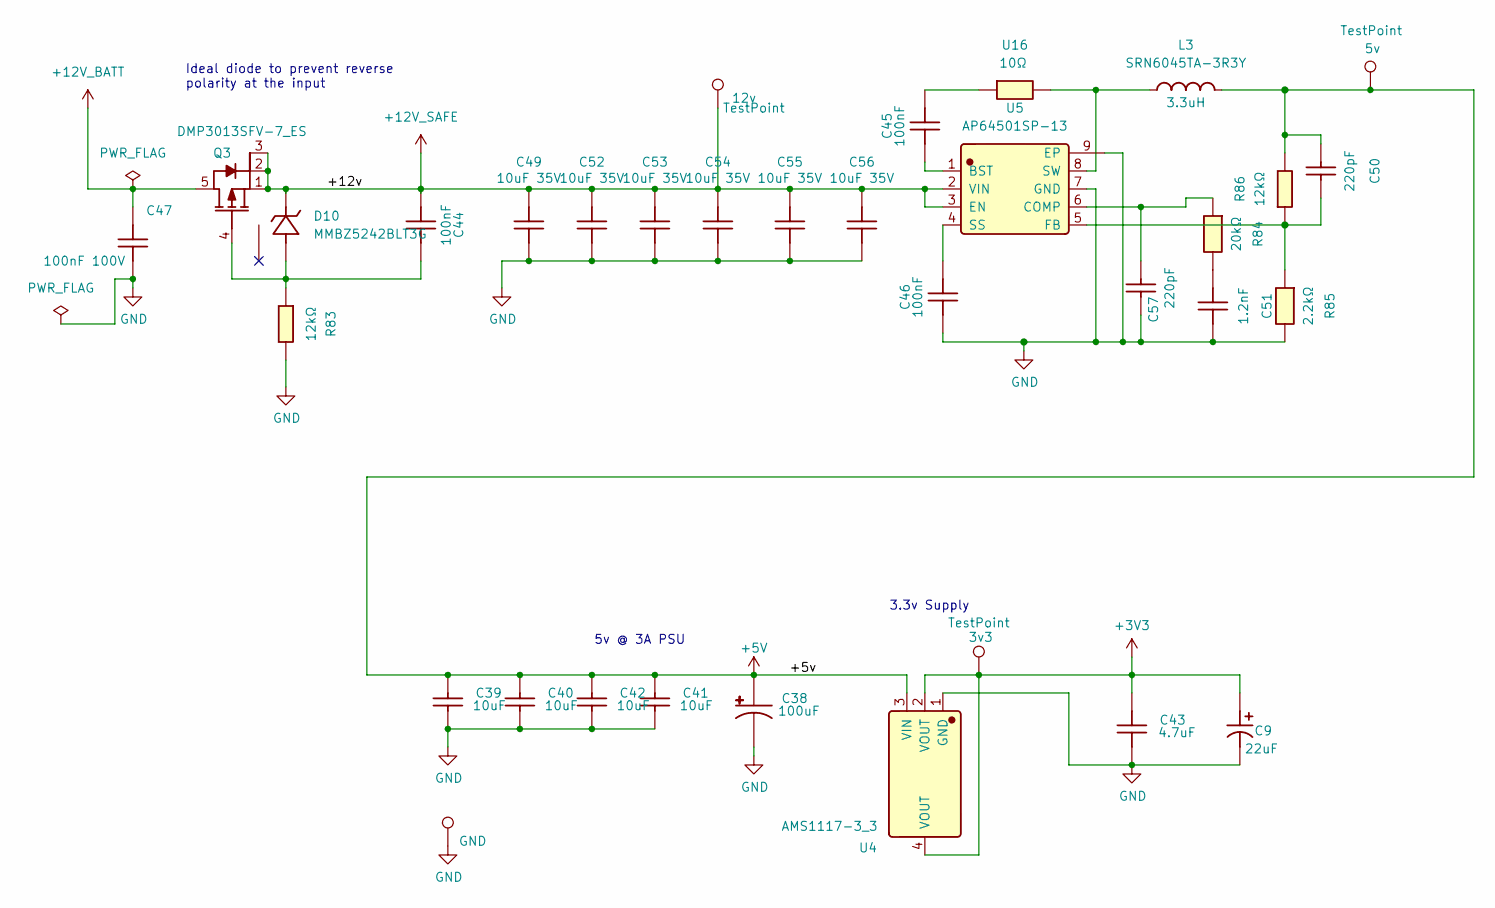
[picture p22: schematic power.kicad_sch]

Parts:
3v3_1: 3v3; TestPoint_Pad_D1.5mm
5v1: 5v; TestPoint_Pad_D1.5mm
12v_1: 12v; TestPoint_Pad_D1.5mm
C9: 25TQC22MYFB; Manufacturer Part 25TQC22MYFB; LCSC C3018703
C38: EEFCX0J101R; Manufacturer Part EEFCX0J101R; LCSC C189619
C39, C40, C41, C42: GCM21BR71A106KE22L; Manufacturer Part GCM21BR71A106KE22L; LCSC C126586
C43: CL10A475KO8NNNC; C_0603_1608Metric; Manufacturer Part CL10A475KO8NNNC; LCSC C19666
C44, C45, C46: CL10B104KB8NNNC; C_0603_1608Metric; Manufacturer Part CL10B104KB8NNNC; LCSC C1591
C47: CC0603KRX7R0BB104; C_0603_1608Metric; Manufacturer Part CC0603KRX7R0BB104; LCSC C113803
C49, C52, C53, C54, C55, C56: GRM21BC8YA106KE11L; C_0805_2012Metric; Manufacturer Part GRM21BC8YA106KE11L; LCSC C469541
C50, C57: CC0603KRX7R0BB221; C_0603_1608Metric; Manufacturer Part CC0603KRX7R0BB221; LCSC C107061
C51: CC0603KRX7R9BB122; C_0603_1608Metric; Manufacturer Part CC0603KRX7R9BB122; LCSC C107073
D10: MMBZ5242BLT3G; Manufacturer Part MMBZ5242BLT3G; LCSC C896784
GND1: GND; TestPoint_Pad_2.0x2.0mm
L3: SRN6045TA-3R3Y; Manufacturer Part SRN6045TA-3R3Y; LCSC C3221229
Q3: DMP3013SFV-7_ES; Manufacturer Part DMP3013SFV-7(ES); LCSC C42412325
R83, R86: RC0603FR-0712KL; R_0603_1608Metric; Manufacturer Part RC0603FR-0712KL; LCSC C114659
R84: FRC0603F2002TS; R_0603_1608Metric; Manufacturer Part FRC0603F2002TS; LCSC C2907011
R85: FRC0603F2201TS; R_0603_1608Metric; Manufacturer Part FRC0603F2201TS; LCSC C2907005
U4: AMS1117-3_3; Manufacturer Part AMS1117-3.3; LCSC C6186
U5: AP64501SP-13; SOIC-8-1EP_3.9x4.9mm_P1.27mm_EP2.95x4.9mm_Mask2.71x3.4mm_Th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; Manufacturer Part AP64501SP-13; LCSC C2071517
U16: CRCW060310R0FKEAHP; R_0603_1608Metric; Manufacturer Part CRCW060310R0FKEAHP; LCSC C313648

Connections:
+3V3: 3v3_1.1 (1_1), C9.1, C43.2, U4.2 (VOUT), U4.4 (VOUT); also elsewhere on the board
+5V: 5v1.1 (1_1), C38.1, C39.2, C40.2, C41.2, C42.2, C50.1, L3.2, R86.2, U4.3 (VIN); also elsewhere on the board
+12V_BATT: C47.2, Q3.5 (D); also elsewhere on the board
+12V_SAFE: 12v_1.1 (1_1), C44.1, C49.2, C52.2, C53.2, C54.2, C55.2, C56.2, D10.3, Q3.1 (S), Q3.2 (S), Q3.3 (S), U5.2 (VIN), U5.3 (EN); also elsewhere on the board
GND: C9.2, C38.2, C39.1, C40.1, C41.1, C42.1, C43.1, C46.1, C47.1, C49.1, C51.2, C52.1, C53.1, C54.1, C55.1, C56.1, C57.2, GND1.1 (1_1), R83.2, R85.2, U4.1 (GND), U5.7 (GND), U5.9 (EP); also elsewhere on the board
unnamed: C45.2, U16.1
unnamed: C51.1, R84.2
unnamed: C44.2, D10.1, Q3.4 (G), R83.1
unnamed: C45.1, U5.1 (BST)
unnamed: C57.1, R84.1, U5.6 (COMP)
unnamed: C50.2, R85.1, R86.1, U5.5 (FB)
unnamed: C46.2, U5.4 (SS)
unnamed: L3.1, U5.8 (SW), U16.2

Notes on the sheet:
Ideal diode to prevent reverse polarity at the input
5v @ 3A PSU
3.3v Supply
