drunkbatya/DrunkDashboard/hardware/kicad/DrunkDashboard_v2/DrunkDashboard_v2.kicad_pcb

## KiCad design hardware/kicad/DrunkDashboard_v2/DrunkDashboard_v2.kicad_pcb (continued)

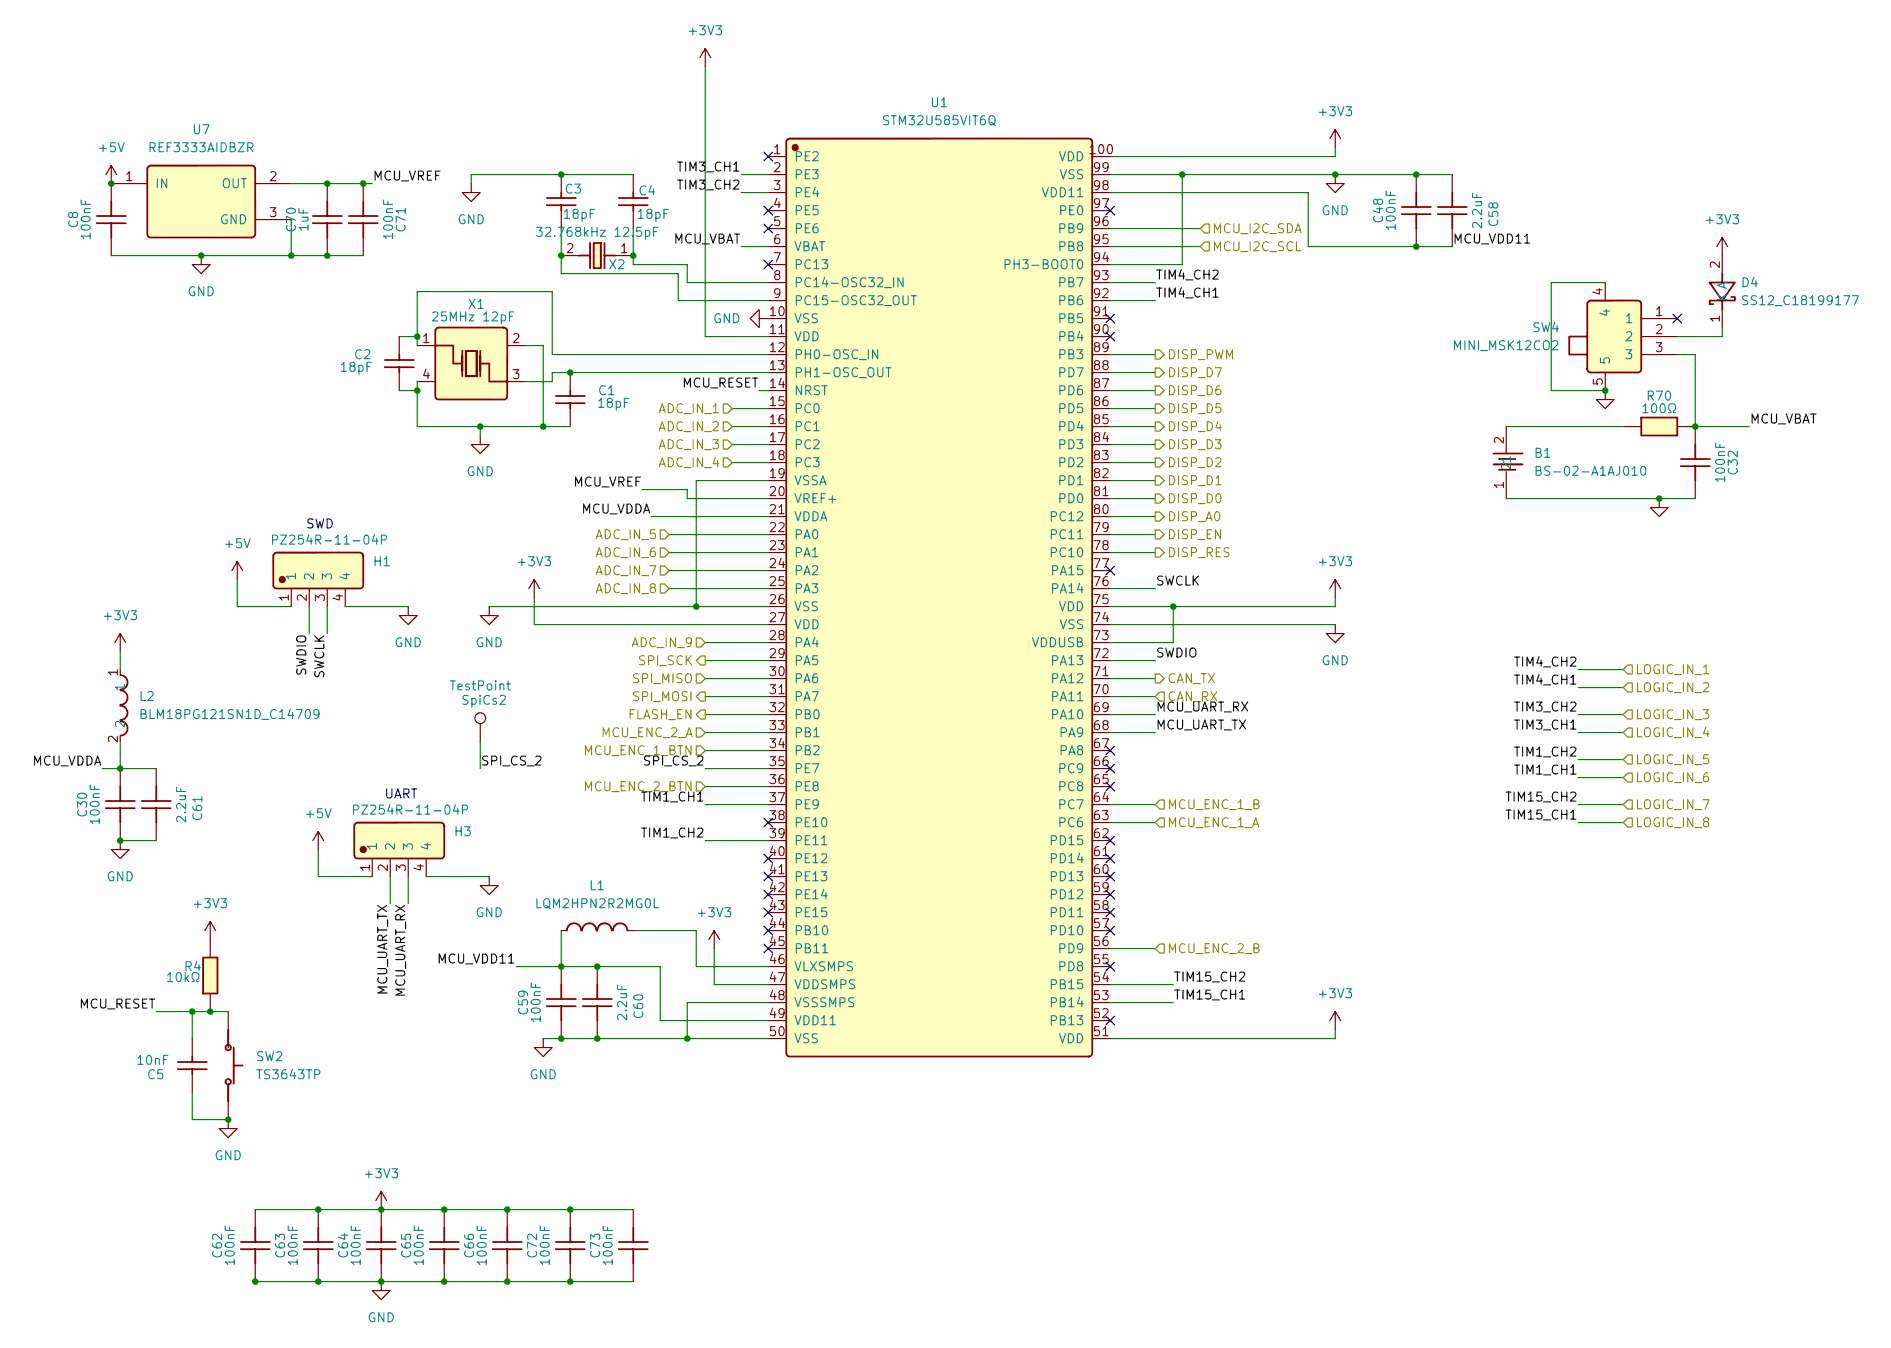
[picture p23: schematic mcu.kicad_sch]

Parts:
B1: BS-02-A1AJ010; Manufacturer Part BS-02-A1AJ010; LCSC C5239862
C1, C2, C3, C4: CL10C180JB8NNNC; C_0603_1608Metric; Manufacturer Part CL10C180JB8NNNC; LCSC C1647
C5: CC0603KRX7R0BB103; C_0603_1608Metric; Manufacturer Part CC0603KRX7R0BB103; LCSC C107059
C8, C30, C32, C48, C59, C62, C63, C64, C65, C66, C71, C72, C73: CL10B104KB8NNNC; C_0603_1608Metric; Manufacturer Part CL10B104KB8NNNC; LCSC C1591
C58, C60, C61: GRM188R61H225KE11D; C_0603_1608Metric; Manufacturer Part GRM188R61H225KE11D; LCSC C162273
C70: CC0603JRX7R7BB105; C_0603_1608Metric; Manufacturer Part CC0603JRX7R7BB105; LCSC C519560
D4: SS12_C18199177; Manufacturer Part SS12; LCSC C18199177
H1, H3: PZ254R-11-04P; Manufacturer Part PZ254R-11-04P; LCSC C492412
L1: LQM2HPN2R2MG0L; Manufacturer Part LQM2HPN2R2MG0L; LCSC C86092
L2: BLM18PG121SN1D_C14709; Manufacturer Part BLM18PG121SN1D; LCSC C14709
R4: RT0603BRD0710KL; R_0603_1608Metric; Manufacturer Part RT0603BRD0710KL; LCSC C95204
R70: PTFR0603B100RN9; R_0603_1608Metric; Manufacturer Part PTFR0603B100RN9; LCSC C394538
SW2: TS3643TP; Manufacturer Part TS3643TP; LCSC C398054
SW4: MINI_MSK12CO2; Manufacturer Part MINI MSK12CO2; LCSC C2681570
SpiCs2_1: SpiCs2; TestPoint_Pad_D1.5mm
U1: STM32U585VIT6Q; LQFP-100_14x14mm_P0.5mm; Manufacturer Part STM32U585VIT6Q; LCSC C5270986
U7: REF3333AIDBZR; Manufacturer Part REF3333AIDBZR; LCSC C130016
X1: X322525MOB4SI; Crystal_SMD_3225-4Pin_3.2x2.5mm; Manufacturer Part X322525MOB4SI; LCSC C9006
X2: Q13FC1350000400; Manufacturer Part Q13FC13500004; LCSC C32346

Connections:
+3V3: C62.2, C63.2, C64.2, C65.2, C66.2, C72.2, C73.2, D4.2 (A), L2.1, R4.2, U1.11 (VDD), U1.27 (VDD), U1.47 (VDDSMPS), U1.51 (VDD), U1.73 (VDDUSB), U1.75 (VDD), U1.100 (VDD); also elsewhere on the board
+5V: C8.2, H1.1, H3.1, U7.1 (IN); also elsewhere on the board
/ADC/ADC_OUT_1: U1.15 (PC0); also elsewhere on the board
/ADC/ADC_OUT_2: U1.16 (PC1); also elsewhere on the board
/ADC/ADC_OUT_3: U1.17 (PC2); also elsewhere on the board
/ADC/ADC_OUT_4: U1.18 (PC3); also elsewhere on the board
/ADC/ADC_OUT_5: U1.22 (PA0); also elsewhere on the board
/ADC/ADC_OUT_6: U1.23 (PA1); also elsewhere on the board
/ADC/ADC_OUT_7: U1.24 (PA2); also elsewhere on the board
/ADC/ADC_OUT_8: U1.25 (PA3); also elsewhere on the board
/ADC/ADC_OUT_9: U1.28 (PA4); also elsewhere on the board
/Buttons/MCU_ENC_1_A: U1.63 (PC6); also elsewhere on the board
/Buttons/MCU_ENC_1_B: U1.64 (PC7); also elsewhere on the board
/Buttons/MCU_ENC_1_BTN: U1.34 (PB2); also elsewhere on the board
/Buttons/MCU_ENC_2_A: U1.33 (PB1); also elsewhere on the board
/Buttons/MCU_ENC_2_B: U1.56 (PD9); also elsewhere on the board
/Buttons/MCU_ENC_2_BTN: U1.36 (PE8); also elsewhere on the board
/CAN/CAN_RX: U1.70 (PA11); also elsewhere on the board
/CAN/CAN_TX: U1.71 (PA12); also elsewhere on the board
/Display/DISP_A0: U1.80 (PC12); also elsewhere on the board
/Display/DISP_D0: U1.81 (PD0); also elsewhere on the board
/Display/DISP_D1: U1.82 (PD1); also elsewhere on the board
/Display/DISP_D2: U1.83 (PD2); also elsewhere on the board
/Display/DISP_D3: U1.84 (PD3); also elsewhere on the board
/Display/DISP_D4: U1.85 (PD4); also elsewhere on the board
/Display/DISP_D5: U1.86 (PD5); also elsewhere on the board
/Display/DISP_D6: U1.87 (PD6); also elsewhere on the board
/Display/DISP_D7: U1.88 (PD7); also elsewhere on the board
/Display/DISP_EN: U1.79 (PC11); also elsewhere on the board
/Display/DISP_PWM: U1.89 (PB3); also elsewhere on the board
/Display/DISP_RES: U1.78 (PC10); also elsewhere on the board
/Flash/FLASH_EN: U1.32 (PB0); also elsewhere on the board
/Flash/SPI_MISO: U1.30 (PA6); also elsewhere on the board
/Flash/SPI_MOSI: U1.31 (PA7); also elsewhere on the board
/Flash/SPI_SCK: U1.29 (PA5); also elsewhere on the board
/LightSensor/SCL: U1.95 (PB8); also elsewhere on the board
/LightSensor/SDA: U1.96 (PB9); also elsewhere on the board
/MCU/MCU_RESET: C5.1, R4.1, SW2.1, U1.14 (NRST)
/MCU/MCU_UART_RX: H3.3, U1.69 (PA10)
/MCU/MCU_UART_TX: H3.2, U1.68 (PA9)
/MCU/MCU_VBAT: C32.1, R70.2, SW4.3, U1.6 (VBAT)
/MCU/MCU_VDD11: C48.1, C58.1, C59.2, C60.2, L1.1, U1.49 (VDD11), U1.98 (VDD11)
/MCU/MCU_VDDA: C30.2, C61.2, L2.2, U1.21 (VDDA)
/MCU/MCU_VREF: C70.2, C71.1, U1.20 (VREF+), U7.2 (OUT)
/MCU/SPI_CS_2: SpiCs2_1.1 (1_1), U1.35 (PE7)
/MCU/SWCLK: H1.3, U1.76 (PA14)
/MCU/SWDIO: H1.2, U1.72 (PA13)
/MCU/TIM1_CH1: U1.37 (PE9); also elsewhere on the board
/MCU/TIM1_CH2: U1.39 (PE11); also elsewhere on the board
/MCU/TIM3_CH1: U1.2 (PE3); also elsewhere on the board
/MCU/TIM3_CH2: U1.3 (PE4); also elsewhere on the board
/MCU/TIM4_CH1: U1.92 (PB6); also elsewhere on the board
/MCU/TIM4_CH2: U1.93 (PB7); also elsewhere on the board
/MCU/TIM15_CH1: U1.53 (PB14); also elsewhere on the board
/MCU/TIM15_CH2: U1.54 (PB15); also elsewhere on the board
GND: B1.1, C1.2, C2.2, C3.1, C4.1, C5.2, C8.1, C30.1, C32.2, C48.2, C58.2, C59.1, C60.1, C61.1, C62.1, C63.1, C64.1, C65.1, C66.1, C70.1, C71.2, C72.1, C73.1, H1.4, H3.4, SW2.2, SW4.4, SW4.5, U1.10 (VSS), U1.19 (VSSA), U1.26 (VSS), U1.48 (VSSSMPS), U1.50 (VSS), U1.74 (VSS), U1.94 (PH3-BOOT0), U1.99 (VSS), U7.3 (GND), X1.2 (GND), X1.4 (GND); also elsewhere on the board
unnamed: B1.2, R70.1
unnamed: D4.1 (K), SW4.2
unnamed: C4.2, U1.8 (PC14-OSC32_IN), X2.1
unnamed: C3.2, U1.9 (PC15-OSC32_OUT), X2.2
unnamed: C2.1, U1.12 (PH0-OSC_IN), X1.1 (OSC1)
unnamed: C1.1, U1.13 (PH1-OSC_OUT), X1.3 (OSC2)
unnamed: L1.2, U1.46 (VLXSMPS)

Notes on the sheet:
SWD
UART

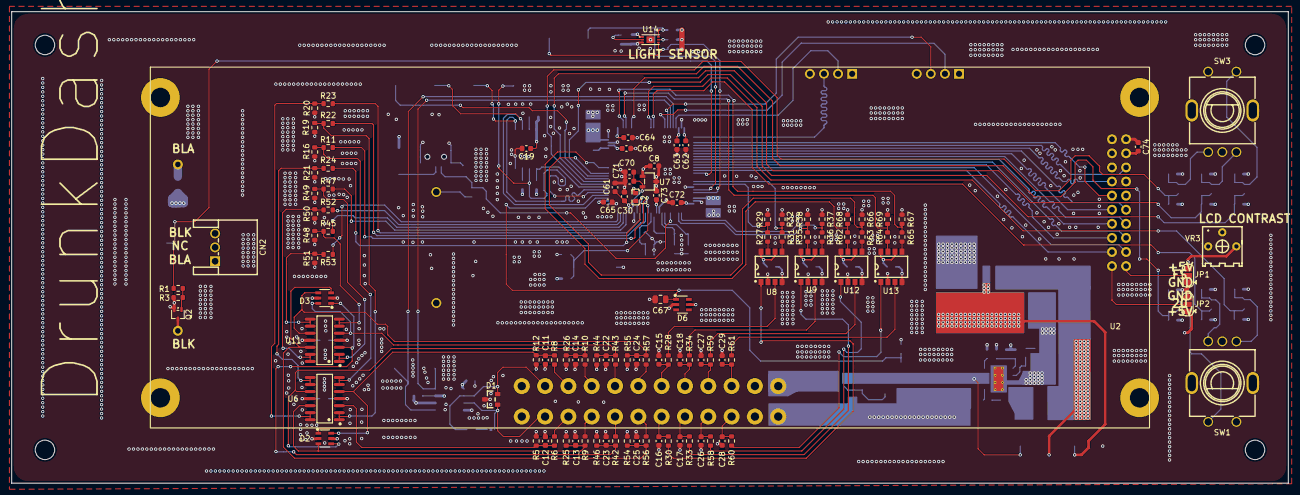
[picture p24: board DrunkDashboard_v2.kicad_pcb from above]

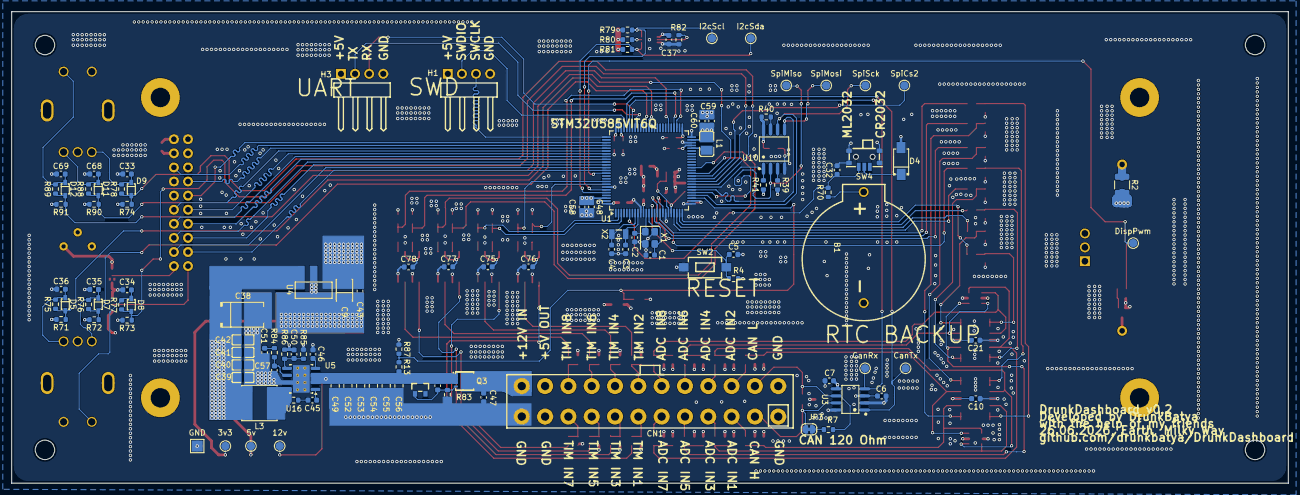
[picture p25: board DrunkDashboard_v2.kicad_pcb from below]

Board: 4 copper layers, 230.0 x 84.9 mm, 223 parts (113 on the bottom side), 141 nets.
