drunkbatya/DrunkDashboard/software/src/furi/drunk_dashboard.c

#include "drunk_dashboard.h"
#include <applications.h>
#include <furi.h>
#include <furi_hal_version.h>
#include <furi_hal_rtc.h>

#include <FreeRTOS.h>

#define TAG "DrunkDashboard"

#define HEAP_CANARY_VALUE 0x8BADF00D

static void drunk_dashboard_print_version(const char* target, const Version* version) {
    if(version) {
        FURI_LOG_I(
            TAG,
            "\r\n\t%s version:\t%s\r\n"
            "\tBuild date:\t\t%s\r\n"
            "\tGit Commit:\t\t%s (%s)%s\r\n"
            "\tGit Branch:\t\t%s",
            target,
            version_get_version(version),
            version_get_builddate(version),
            version_get_githash(version),
            version_get_gitbranchnum(version),
            version_get_dirty_flag(version) ? " (dirty)" : "",
            version_get_gitbranch(version));
    } else {
        FURI_LOG_I(TAG, "No build info for %s", target);
    }
}

void drunk_dashboard_init(void) {
    drunk_dashboard_print_version("Firmware", furi_hal_version_get_firmware_version());

    FURI_LOG_I(TAG, "Boot mode %d, starting services", furi_hal_rtc_get_boot_mode());

    for(size_t i = 0; i < DRUNK_DASHBOARD_SERVICES_COUNT; i++) {
        FURI_LOG_D(TAG, "Starting service %s", DRUNK_DASHBOARD_SERVICES[i].name);

        FuriThread* thread = furi_thread_alloc_service(
            DRUNK_DASHBOARD_SERVICES[i].name,
            DRUNK_DASHBOARD_SERVICES[i].stack_size,
            DRUNK_DASHBOARD_SERVICES[i].app,
            NULL);
        furi_thread_set_appid(thread, DRUNK_DASHBOARD_SERVICES[i].appid);

        furi_thread_start(thread);
    }

    FURI_LOG_I(TAG, "Startup complete");
}

void vApplicationGetIdleTaskMemory(
    StaticTask_t** tcb_ptr,
    StackType_t** stack_ptr,
    uint32_t* stack_size) {
    *tcb_ptr = memmgr_alloc_from_pool(sizeof(StaticTask_t));
    *stack_ptr = memmgr_alloc_from_pool(sizeof(StackType_t) * configIDLE_TASK_STACK_DEPTH);
    *stack_size = configIDLE_TASK_STACK_DEPTH;
}

void vApplicationGetTimerTaskMemory(
    StaticTask_t** tcb_ptr,
    StackType_t** stack_ptr,
    uint32_t* stack_size) {
    *tcb_ptr = memmgr_alloc_from_pool(sizeof(StaticTask_t));
    *stack_ptr = memmgr_alloc_from_pool(sizeof(StackType_t) * configTIMER_TASK_STACK_DEPTH);
    *stack_size = configTIMER_TASK_STACK_DEPTH;
}

void vApplicationGetRandomHeapCanary(portPOINTER_SIZE_TYPE* pxHeapCanary) {
    *pxHeapCanary = HEAP_CANARY_VALUE;
}
