drunkbatya/DrunkDashboard/software/src/targets/common/furi_hal/furi_hal_bus.h

#pragma once

#ifdef __cplusplus
extern "C" {
#endif

#include "stm32u5xx.h"
#include "stdbool.h"

typedef enum {
    FuriHalBusAHB1_GRP1,
    FuriHalBusDMA1,
    FuriHalBusDMA2,
    FuriHalBusCRC,
    FuriHalBusTSC,

    FuriHalBusAHB2_GRP1,
    FuriHalBusGPIOA,
    FuriHalBusGPIOB,
    FuriHalBusGPIOC,
    FuriHalBusGPIOD,
    FuriHalBusGPIOE,
    FuriHalBusGPIOH,
    FuriHalBusADC,
    FuriHalBusAES1,

    FuriHalBusAHB3_GRP1,
    FuriHalBusPKA,
    FuriHalBusAES2,
    FuriHalBusRNG,
    FuriHalBusFLASH,

    FuriHalBusAPB1_GRP1,
    FuriHalBusTIM2,
    FuriHalBusTIM3,
    FuriHalBusTIM5,
    FuriHalBusSPI2,
    FuriHalBusI2C1,
    FuriHalBusI2C3,
    FuriHalBusCRS,
    FuriHalBusLPTIM1,

    FuriHalBusAPB1_GRP2,
    FuriHalBusLPUART1,
    FuriHalBusLPTIM2,
    FuriHalBusFDCAN1,

    FuriHalBusAPB2_GRP1,
    FuriHalBusTIM1,
    FuriHalBusTIM8,
    FuriHalBusSPI1,
    FuriHalBusUSART1,
    FuriHalBusTIM16,
    FuriHalBusTIM17,
    FuriHalBusSAI1,
    FuriHalBusMAX,
} FuriHalBus;

/** Early initialization */
void furi_hal_bus_init_early(void);

/** Early de-initialization */
void furi_hal_bus_deinit_early(void);

/**
 * Enable a peripheral by turning the clocking on and deasserting the reset.
 * @param [in] bus Peripheral to be enabled.
 * @warning Peripheral must be in disabled state in order to be enabled.
 */
void furi_hal_bus_enable(FuriHalBus bus);

/**
 * Reset a peripheral by sequentially asserting and deasserting the reset.
 * @param [in] bus Peripheral to be reset.
 * @warning Peripheral must be in enabled state in order to be reset.
 */
void furi_hal_bus_reset(FuriHalBus bus);

/**
 * Disable a peripheral by turning the clocking off and asserting the reset.
 * @param [in] bus Peripheral to be disabled.
 * @warning Peripheral must be in enabled state in order to be disabled.
 */
void furi_hal_bus_disable(FuriHalBus bus);

/** Check if peripheral is enabled
 *
 * @param[in]  bus   The peripheral to check
 *
 * @return     true if enabled or always enabled, false otherwise
 */
bool furi_hal_bus_is_enabled(FuriHalBus bus);

#ifdef __cplusplus
}
#endif
