drunkbatya/DrunkDashboard/software/src/targets/common/furi_hal/furi_hal_version_device.c

#include <furi_hal_version.h>
#include <furi_hal_target_hw.h>

bool furi_hal_version_do_i_belong_here(void) {
    return furi_hal_version_get_hw_target() == TARGET;
}

const char* furi_hal_version_get_model_name(void) {
    return FURI_HAL_TARGET_MODEL_NAME;
}

const char* furi_hal_version_get_model_code(void) {
    return FURI_HAL_TARGET_MODEL_CODE;
}

const char* furi_hal_version_get_fcc_id(void) {
    return "";
}

const char* furi_hal_version_get_ic_id(void) {
    return "";
}

const char* furi_hal_version_get_mic_id(void) {
    return "";
}

const char* furi_hal_version_get_srrc_id(void) {
    return "";
}

const char* furi_hal_version_get_ncc_id(void) {
    return "";
}
