drunkbatya/DrunkDashboard/software/src/applications/user/dashboard/scenes/dashboard_scene.c

#include "dashboard_scene.h"

// Generate scene on_enter handlers array
#define ADD_SCENE(prefix, name, id) prefix##_scene_##name##_on_enter,
void (*const dashboard_scene_on_enter_handlers[])(void*) = {
#include "dashboard_scene_config.h"
};
#undef ADD_SCENE

// Generate scene on_event handlers array
#define ADD_SCENE(prefix, name, id) prefix##_scene_##name##_on_event,
bool (*const dashboard_scene_on_event_handlers[])(void* context, SceneManagerEvent event) = {
#include "dashboard_scene_config.h"
};
#undef ADD_SCENE

// Generate scene on_exit handlers array
#define ADD_SCENE(prefix, name, id) prefix##_scene_##name##_on_exit,
void (*const dashboard_scene_on_exit_handlers[])(void* context) = {
#include "dashboard_scene_config.h"
};
#undef ADD_SCENE

// Initialize scene handlers configuration structure
const SceneManagerHandlers dashboard_scene_handlers = {
    .on_enter_handlers = dashboard_scene_on_enter_handlers,
    .on_event_handlers = dashboard_scene_on_event_handlers,
    .on_exit_handlers = dashboard_scene_on_exit_handlers,
    .scene_num = DashboardSceneNum,
};
