drunkbatya/DrunkDashboard/software/src/applications/user/dashboard/scenes/dashboard_scene.h

#pragma once

#include <gui/scene_manager.h>

// Generate scene id and total number
#define ADD_SCENE(prefix, name, id) DashboardScene##id,
typedef enum {
#include "dashboard_scene_config.h"
    DashboardSceneNum,
} DashboardScene;
#undef ADD_SCENE

extern const SceneManagerHandlers dashboard_scene_handlers;

// Generate scene on_enter handlers declaration
#define ADD_SCENE(prefix, name, id) void prefix##_scene_##name##_on_enter(void*);
#include "dashboard_scene_config.h"
#undef ADD_SCENE

// Generate scene on_event handlers declaration
#define ADD_SCENE(prefix, name, id) \
    bool prefix##_scene_##name##_on_event(void* context, SceneManagerEvent event);
#include "dashboard_scene_config.h"
#undef ADD_SCENE

// Generate scene on_exit handlers declaration
#define ADD_SCENE(prefix, name, id) void prefix##_scene_##name##_on_exit(void* context);
#include "dashboard_scene_config.h"
#undef ADD_SCENE
