drunkbatya/DrunkDashboard/(commit log)

2026-07-02 Add hardware
    [DrunkDashboardZaz_v1.kicad_pcb, DrunkDashboardZaz_v1.kicad_sch, adc.kicad_sch, bom.csv, buttons.kicad_sch, can.kicad_sch, connector.kicad_sch, designators.csv]
2026-07-02 Add ported furi, furi_hal, and most core parts of flipper os, icons etc....
    [canvas.c, check.c]
2026-07-08 Fix var item list
    [canvas.c]
2026-07-30 Fix d2 encoder specific
    [furi_hal_encoder.c]
2026-07-30 Use only software encoders
2026-08-03 Use timer encoder
2026-08-05 Add dashboard view from FlipperCanbus, fix lptim encoder
    [dashboard_can_worker.c, dashboard_can_worker.h, dashboard_can_worker_i.h, dashboard_scene_canbus.c, dashboard_scene_dashboard.c]
